ShlomoAbrams/ascon/docs/akiva/תאור פונקציית ההתמרה.pdf

בס"ד

## פונקציית התמורה - "permutations( "ובקיצור "P)"

קלט הפונקציה הינו ה - "State( "בקוד נקרא "INPUT_ STATE)". גודלו 320 סיביות, והוא מורכב מחמישה מילים שגודל כל אחד מהם 64 בית:

State = S0 ∥ S1 ∥ S2 ∥ S3 ∥ S4

0S - וקטור אתחול ה IV.

1S - חצי ראשון של המפתח - K.

2S - חצי שני של המפתח - K.

3S - חצי ראשון של ה-Nonce.

4S - חצי שני של ה-Nonce.

הפונקציה מבצעת מספר סיבובים - "Rounds( "ובקיצור "rnd )"הנע בטוח: 16 ≥ nr ≥ 1

כל סיבוב בפונקציה מורכב משלושה משלושה שלבים עיקריים, המתבצעים בזה אחר זה:

p = pL ∘ pS ∘ pC

.Constant Addition Layer - | הקבועים | הוספת | שכבת | – pC .1
.Substitution Layer - | ההחלפה | שכבת | – pS .2
.Linear Diffusion Layer - | הליניארית | הדיפוזיה | שכבת | – pL .3

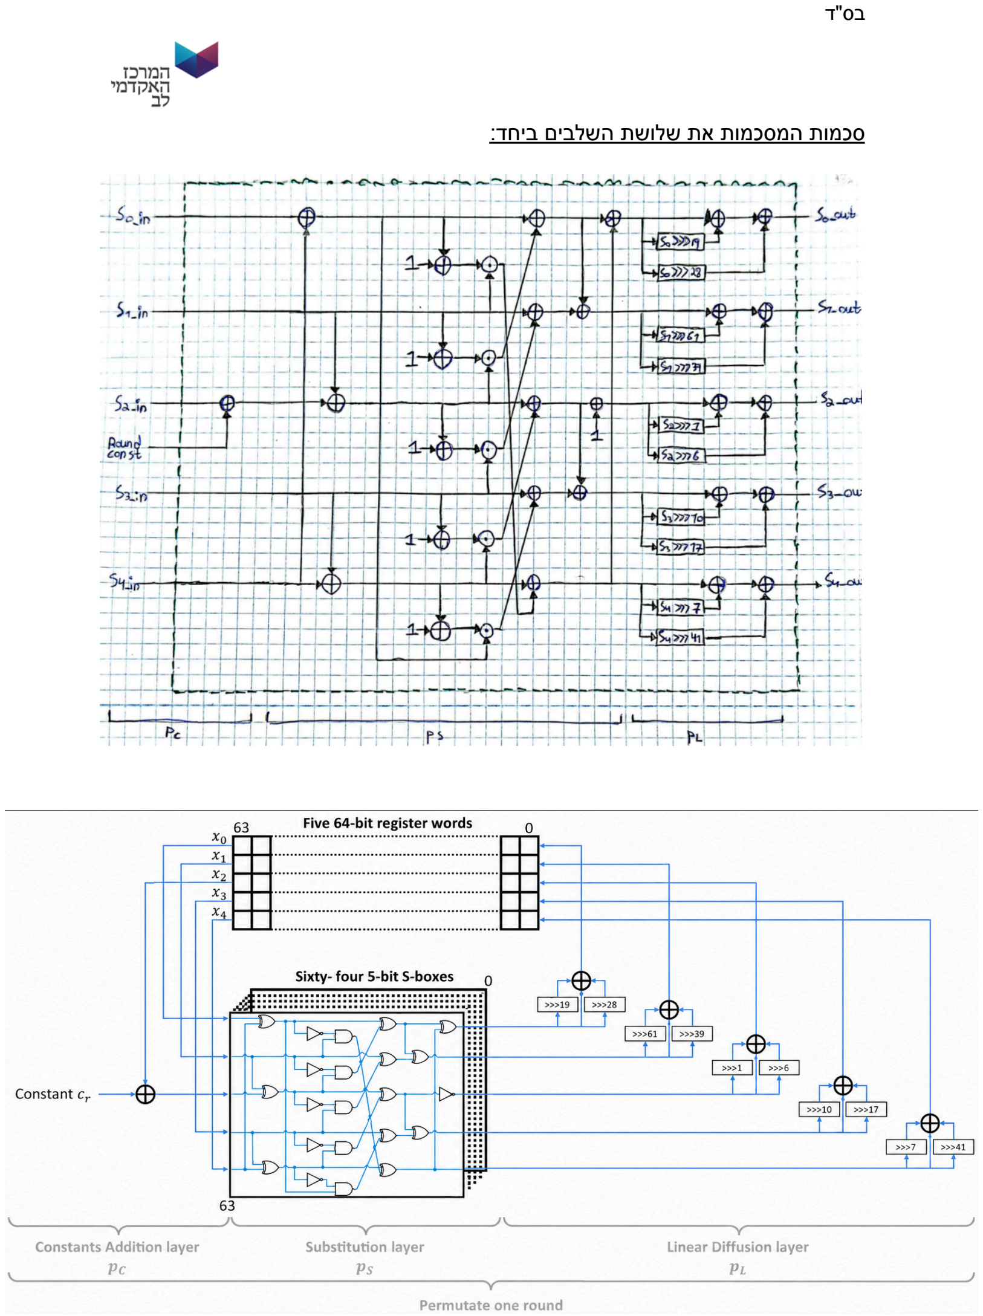
[picture p18: page 2]

סכמות המסכמות את שלושת השלבים ביחד:

שלושת השלבים בהרחבה:

.1 שלב ראשון - הוספת הקבועים:

ביצוע XOR בין בין המילה 2S שב - tatS לבין מספר קבוע, אחד מאלה המופיעים בטבלה הבאה:

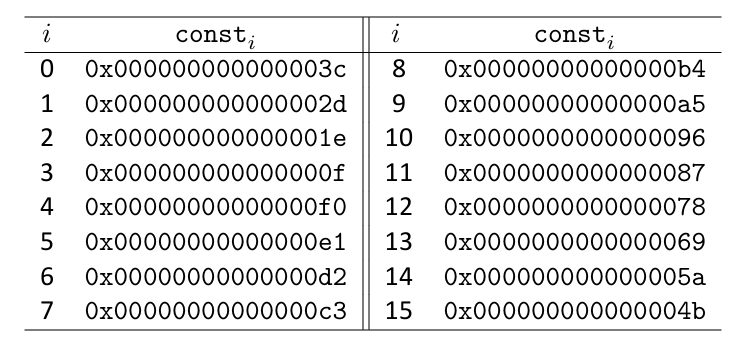
[picture p19: figure]

המספר הספציפי נקבע ע"פ הנוסחה הבאה:

Ci = const
16−rnd+i
אורך כל קבוע הינו 64 ביט, אך כיוון ש- 56 הביטים הראשונים שלו הם אפס, בפועל פעולת ה־XOR משפיעה רק על 8 הביטים ה LSB ׁ ׁ(הימניים ביותר( של 2S, ו- 56 הביטים הנותרים נשארים ללא שינוי.

מטרתו של כל שלב זה הינה יצירת הבדלים בין כל סיבוב ליתר הסיבובים.

סיגנל המוצא לאחר פעולה זו נקרא בקיצור pc( כלומר constan permutation -המצב אחרי הוספת הקבוע(.

.2 שלב שני - שכבת ההחלפה:

בהתייחס ל- State כמסודר בצורה "אנכית" באופן הבא:

נוצרות למעשה 64 קבוצות, כל קבוצה בעלת 5 ביטים בעלי אותו אינדקס המורכבת מחמשת המילים של ה State( ביט אחד מכל מילה(. בו זמנית עבור כל אחת מ- 64 הקבוצות, באופן מקביל, נכנסים כל חמישית ביטים ל"קופסה שחורה" שנקראת Box-S בה מחלפים את הביטים שנכנסו Xi, ומייצרים במוצא חמישה ביטים אחרים Yi.

(y0,..., y4) = SBOX(x0,..., x4) השינוי נקבע ע"פ הסכמה הבאה:

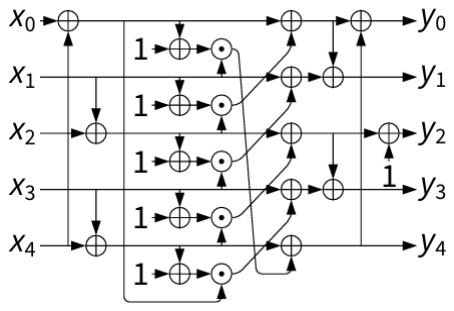
[picture p20: figure]

:הבא | באופן | מוגדרים | X0,X1,X2,X3,X4 | כאשר

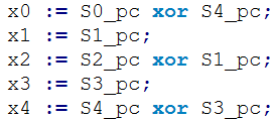
[picture p21: figure]

או בעזרת הטבלה הבאה בה מפורשים כל 32 הצירופים האפשריים:

מטרת שלב זה הינה ליצור "ערבוב" כך ששינוי של ביט אחד בקלט ישפיע על המון ביטים בפלט. פעולה זו יוצרת ערבוב לא-ליניארי חזק )מתמטיקה מורכבת(

לסיגנל המוצא לאחר פעולה זו נקרא בקיצור ps( כלומר permutation substitution - המצב אחרי ה- SBox).

.3 שלב שלישי - שכבת הפיזור )"דיפוזיה"( הליניארית: בשלב זה אנו מבצעים פיזור וערבוב בתוך כל אחת מ5- המילים ׂׂ)4S.…0S )בנפרד.

המטרה היא לגרום לכך ששינוי של ביט אחד יחיד יתפשט במהירות וישפיע על כל שאר הביטים בתוך המילה.
לכל אחת מ5- המילים יש נוסחת הזזה ייחודית משלה:

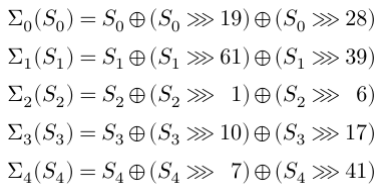
[picture p22: figure]

של עצמה, אנו מזיזים | 1 | בעזרת ביצוע XOR של כל מילה עם שתי גרסאות "מוזזות"
את הביטים ומפזרים אותם לכל אורך ה-State. למוצא לאחר פעולה זו נקרא: " OUTPUT_STATE" .

1
לכל מילה יש מרחקי הזזה שונים, שנקבעו כדי למקסם את הערבוב. )סימון הזזה: >>> (.

קידוד פונקצית התמורה:

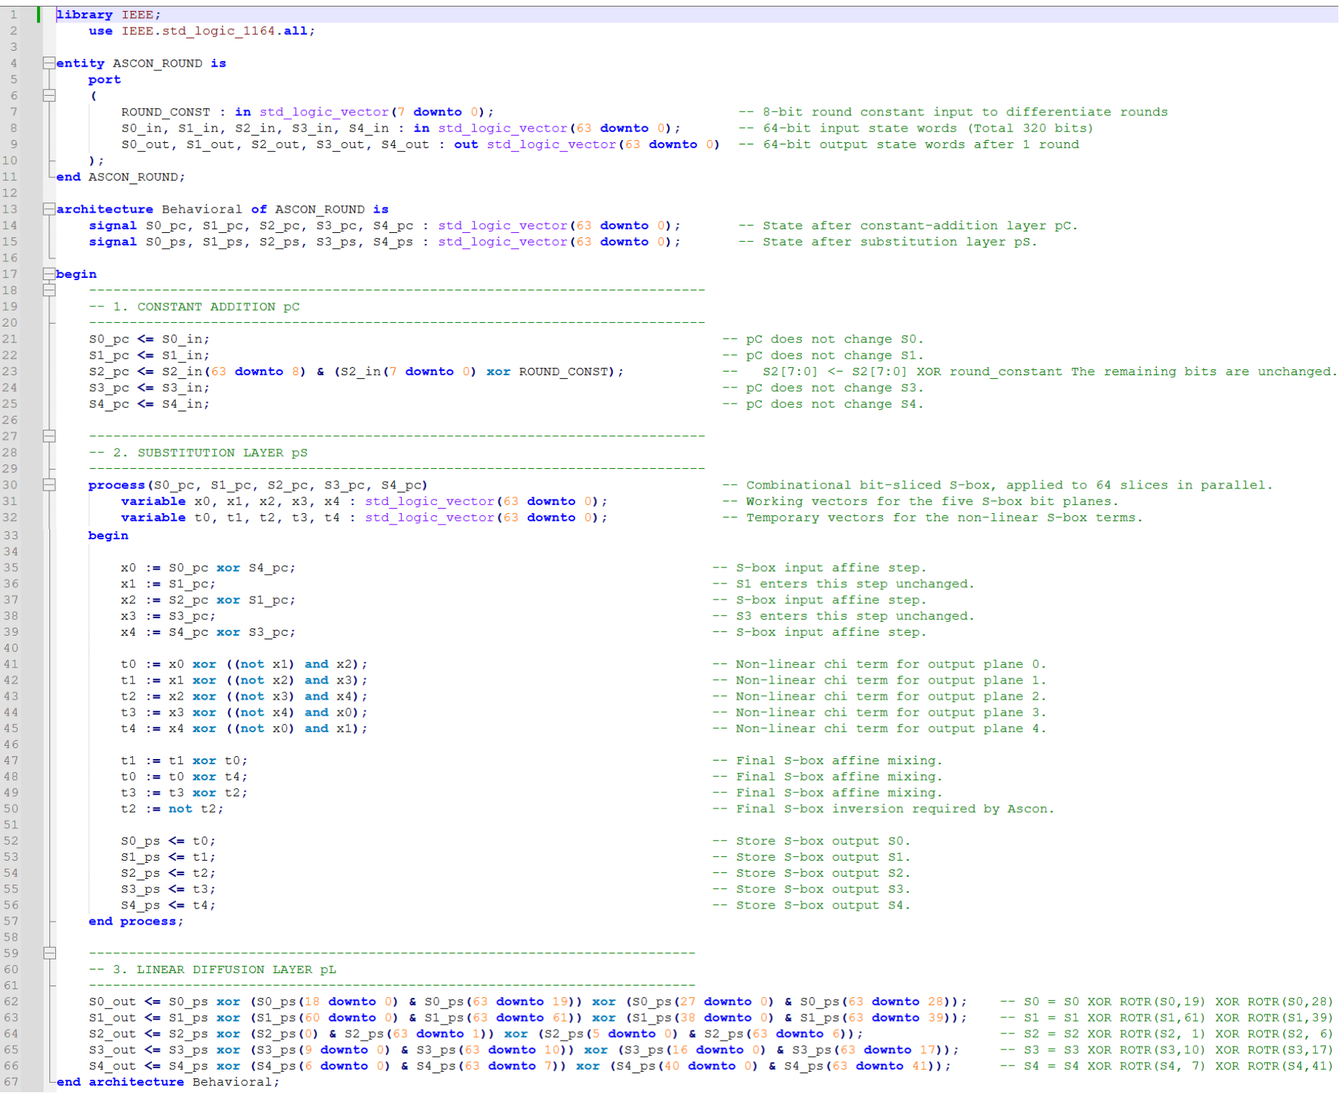
[picture p23: figure]
