ShlomoAbrams/ascon/docs/nist/NIST.SP.800-232.pdf

## NIST Special Publication 800 NIST SP 800-232

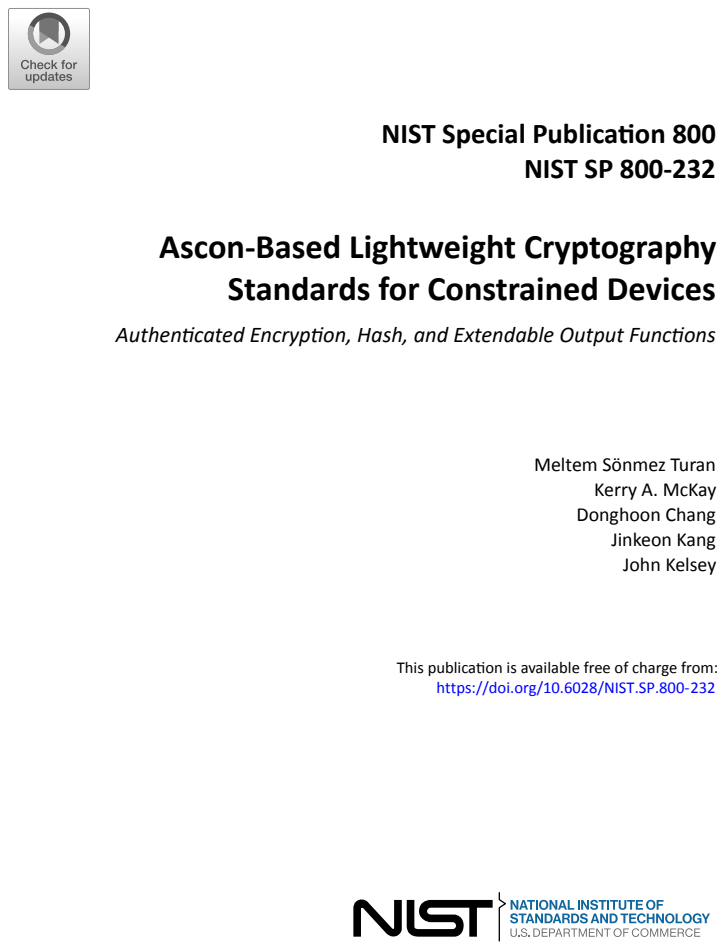
[picture p38: page 1]
Kerry A. McKay Donghoon Chang Jinkeon Kang John Kelsey

Ascon-Based Lightweight Cryptography
Standards for Constrained Devices

Authenticated Encryption, Hash, and Extendable Output Functions

Meltem Sönmez Turan

This publication is available free of charge from:
https://doi.org/10.6028/NIST.SP.800-232

## NIST Special Publication 800 NIST SP 800-232

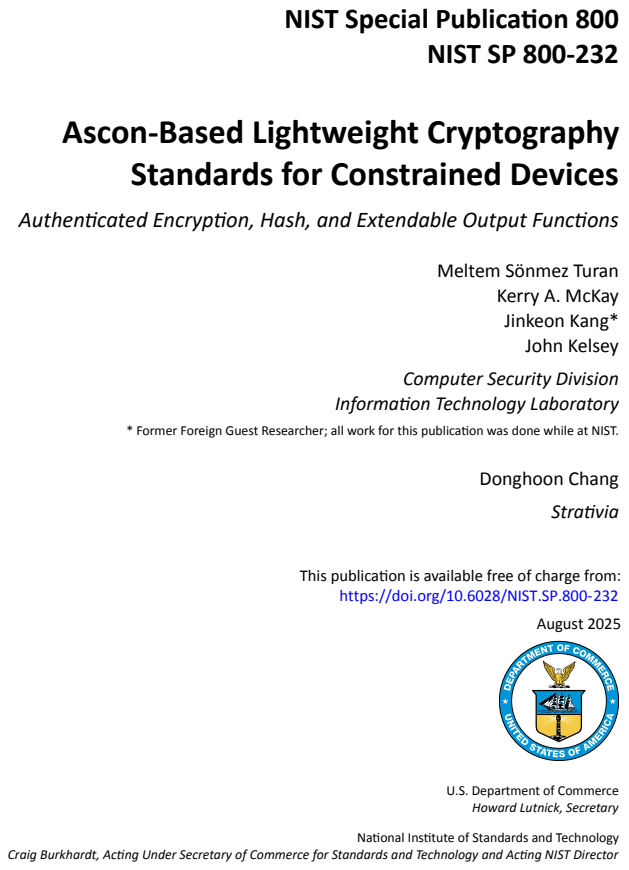
[picture p39: page 2]
Kerry A. McKay Jinkeon Kang* John Kelsey; Donghoon Chang; Strativia; August 2025

Ascon-Based Lightweight Cryptography
Standards for Constrained Devices

Authenticated Encryption, Hash, and Extendable Output Functions

Meltem Sönmez Turan

Computer Security Division

Information Technology Laboratory

* Former Foreign Guest Researcher; all work for this publication was done while at NIST.

This publication is available free of charge from:
https://doi.org/10.6028/NIST.SP.800-232

U.S. Department of Commerce
Howard Lutnick, Secretary

National Institute of Standards and Technology

Craig Burkhardt, Acting Under Secretary of Commerce for Standards and Technology and Acting NIST Director

NIST SP 800-232

### August 2025

Ascon-Based Lightweight Cryptography Standards for Constrained Devices

Certain equipment, instruments, software, or materials, commercial or non-commercial, are identified in this paper in order to specify the experimental procedure adequately. Such identification does not imply recommendation or endorsement of any product or service by NIST, nor does it imply that the materials or equipment identified are necessarily the best available for the purpose.

There may be references in this publication to other publications currently under development by NIST in accordance with its assigned statutory responsibilities. The information in this publication, including concepts and methodologies, may be used by federal agencies even before the completion of such companion publications. Thus, until each publication is completed, current requirements, guidelines, and procedures, where they exist, remain operative. For planning and transition purposes, federal agencies may wish to closely follow the development of these new publications by NIST.

Organizations are encouraged to review all draft publications during public comment periods and provide feedback to NIST. Many NIST cybersecurity publications, other than the ones noted above, are available at https://csrc.nist.gov/publications

Authority

This publication has been developed by NIST in accordance with its statutory responsibilities under the Federal Information Security Modernization Act (FISMA) of 2014, 44 U.S.C. § 3551 et seq., Public Law (P.L.) 113-283. NIST is responsible for developing information security standards and guidelines, including minimum requirements for federal information systems, but such standards and guidelines shall not apply to national security systems without the express approval of appropriate federal officials exercising policy authority over such systems. This guideline is consistent with the requirements of the Office of Management and Budget (OMB) Circular A-130.

Nothing in this publication should be taken to contradict the standards and guidelines made mandatory and binding on federal agencies by the Secretary of Commerce under statutory authority. Nor should these guidelines be interpreted as altering or superseding the existing authorities of the Secretary of Commerce, Director of the ORCID, or any other federal official. This publication may be used by nongovernmental organizations on a voluntary basis and is not subject to copyright in the United States. Attribution would, however, be appreciated by NIST.

NIST Technical Series Policies
Copyright, Use, and Licensing Statements (https://doi.org/10.6028/NIST-TECHPUBS.CROSSMARK-POLICY)
NIST Technical Series Publication Identifier Syntax (https://www.nist.gov/nist-research-library/nist-technical-series-publications-author-instructions)

Publication History
Approved by the NIST Editorial Review Board on 2025-07-09

How to cite this NIST Technical Series Publication:
Meltem Sönmez Turan, Kerry A. McKay, Donghoon Chang, Jinkeon Kang, John Kelsey (2025) Ascon-Based Lightweight Cryptography Standards for Constrained Devices. (National Institute of Standards and Technology, Gaithersburg, MD), NIST Special Publication (SP) NIST SP 800-232. https://doi.org/10.6028/NIST.SP.800-232

Standards for Constrained Devices

### August 2025

Author ORCID iDs
Meltem Sönmez Turan: 0000-0002-1950-7130 Kerry A. McKay: 0000-0002-5956-587X Donghoon Chang: 0000-0003-1249-2869 Jinkeon Kang: 0000-0003-2142-8236
John Kelsey: 0000-0002-3427-1744

Contact Information
SP800-232-comments@list.nist.gov

Additional Information
Additional information about this publication is available at https://csrc.nist.gov/pubs/sp/800/232/final, including related content, potential updates, and document history.

All comments are subject to release under the Freedom of Information Act (FOIA).

### August 2025

Standards for Constrained Devices

Abstract

In 2023, the National Institute of Standards and Technology (NIST) announced the selection of the Ascon family of algorithms designed by Dobraunig, Eichlseder, Mendel, and Schläffer to provide efficient cryptographic solutions for resource-constrained devices. This decision emerged from a rigorous, multi-round lightweight cryptography standardization process. The Ascon family includes a suite of cryptographic primitives that provide Authenticated Encryption with Associated Data (AEAD), hash function, and eXtendable Output Function (XOF) capabilities. The Ascon family is characterized by lightweight, permutation-based primitives and providesrobustsecurity, efficiency, and flexibility, making it ideal for resource-constrained environments, such as Internet of Things (IoT) devices, embedded systems, and low-power sensors. The family is developed to offer a viable alternative when the Advanced Encryption Standard (AES) may not perform optimally. This standard outlines the technical specifications and security properties of Ascon-AEAD128, Ascon-Hash256,
Ascon-XOF128, and Ascon-CXOF128.

Keywords

Ascon; authenticated encryption; constrained devices; eXtendable Output Function (XOF); hash function; lightweight cryptography; permutation-based cryptography; standardization.

Reports on Computer Systems Technology

The Information Technology Laboratory (ITL) at the National Institute of Standards and Technology (NIST) promotesthe U.S. economy and public welfare by providing technical leadership for the Nation’s measurement and standards infrastructure. ITL develops tests, test methods, reference data, proof of concept implementations, and technical analyses to advance the development and productive use of information technology. ITL’s responsibilities include the development of management, administrative, technical, and physical standards and guidelines for the cost-effective security and privacy of other than national securityrelated information in federal information systems. The Special Publication 800-series reports on ITL’s research, guidelines, and outreach efforts in information system security, and its collaborative activities with industry, government, and academic organizations.

i

### August 2025

Standards for Constrained Devices

### Patent Disclosure Notice

NOTICE: ITL has requested that holders of patent claims whose use may be required for compliance with the guidance or requirements of this publication disclose such patent claimsto ITL. However, holders of patents are not obligated to respond to ITL callsfor patents and ITL has not undertaken a patent search in order to identify which, if any, patents may apply to this publication.

As of the date of publication and following call(s) for the identification of patent claims whose use may be required for compliance with the guidance or requirements of this publication, no such patent claims have been identified to ITL.

No representation is made or implied by ITL that licenses are not required to avoid patent infringement in the use of this publication.

ii

### August 2025

Standards for Constrained Devices

## Table of Contents

3.3. Substitution Layer pS

iii

### August 2025

Standards for Constrained Devices

iv

### August 2025

Standards for Constrained Devices

## List of Tables

Table 5. The constants consti
to derive round constants of the Ascon permutations. 9

Table 7. Security strength of Ascon-AEAD128 with λ-bit tag in the u-key setting,

Table 8. Integrity security strength of Ascon-AEAD128 with u keys in the nonce-

## Table 9. Security strengths of Ascon-Hash256, Ascon-XOF128, and Ascon-CXOF128

Table 10. Address for each byte of Ascon state word Si
in memory on little-endian

Table 11. Examples of padding an unsigned integer x to a 64-bit block, where x encodes a sequence of bytes that each have value 0xFF in little-endian byte order ... 38

Table 12. Precomputed initialization phase valuesfor Ascon-Hash256, Ascon-XOF128,

v

### August 2025

Standards for Constrained Devices

## List of Figures

Figure 2. Application of substitution layer pS

Figure 10. Representation of the Ascon state as 64-bit unsigned integers, byte se-

vi

### August 2025

Standards for Constrained Devices

### Acknowledgments

The authors of the standard express their gratitude to the Ascon designers — Christoph Dobraunig, Maria Eichlseder, Florian Mendel, and Martin Schläffer — for their valuable comments and suggestions during the standardization process.

The authors also acknowledge and appreciate contributions from their colleagues at NIST during the selection process, including Lawrence Bassham, Çağdaş Çalık, Deukjo Hong, and Noah Waller. The authors also thank Elaine Barker, Luís T. A. N. Brandão, Lily Chen, Andrew Regenscheid, Noah Ross, Sara Kerman, Yu Long Chen, and Yu Sasaki for their technical and administrative support.

vii

### August 2025

Standards for Constrained Devices

### 1. Introduction

This standard specifies the Ascon family of algorithms to provide Authenticated Encryption with Associated Data (AEAD), a hash function, and two eXtendable Output Functions (XOFs). The Ascon family is designed to be efficient in constrained environments. The algorithms included in this standard are as follows:
1. Ascon-AEAD128 is a nonce-based AEAD scheme, offering 128-bit security strength

in the single-key setting.
2. Ascon-Hash256 is a cryptographic hash function that produces a 256-bit hash of the input messages, offering a security strength of 128 bits.
3. Ascon-XOF128 is a XOF, where the output size of the hash of the message can be

selected by the user, and the supported security strength is up to 128 bits.
4. Ascon-CXOF128 is a customized XOF that allows users to specify a customization string and choose the output size of the message hash. It supports a security strength of up to 128 bits.

Development of the Ascon family. Ascon (version v1) [1] was firstsubmitted to CAESAR (Competition for Authenticated Encryption: Security, Applicability, and Robustness)

1

1CAESAR is a competition organized by a group of international cryptologic researchers to identify a portfolio of authenticated encryption schemes that offer advantages over AES-GCM and are suitable for widespread adoption. The final portfolio of the competition was announced in February 2019. For more information, see https://competitions.cr.yp.to/caesar.html.

in 2014. The
submission included two AEAD algorithms: a primary recommendation, Ascon-128, with a 128-bit key and the secondary recommendation, Ascon-96, with a 96-bit key. Updated versions v1.1 [2] for Round 2 and v1.2 [3] for Round 3 included minortweaks,such asreordering the round constants, and the secondary recommendation was updated to Ascon-128a. In 2019, Ascon-128 and Ascon-128a were selected as the first choice for the lightweight authenticated encryption use case in the final portfolio of the CAESAR competition.

NIST Lightweight Cryptography Standardization Process. In 2015, the National Institute of Standards and Technology (NIST) initiated the Lightweight Cryptography Standardization Process to develop cryptographic standards that are suitable for constrained environments in which conventional cryptographic standards(e.g., AES-GCM [4, 5], SHA-2 [6] and SHA-3 [7] hash function families) may be resource-intensive. In February 2023, NIST announced the decision to standardize the Ascon family [8] for lightweight cryptography applications. For more information, refer to NIST Internal Report (IR) 8268 [9], IR 8369 [10], and IR 8454 [11].

Differencesfrom the Ascon submission v1.2. The technical differences between thisstandard and the Ascon submission [8] are provided below:

1. Permutations. The Ascon submission defined three Ascon permutations with 6, 8, and 12 rounds. This standard specifies additional Ascon permutations by providing round

### August 2025

Standards for Constrained Devices

constants for up to 16 rounds to accommodate potential functionality extensions in the future.

2. AEAD variants. The Ascon submission package defined AEAD variants ASCON-128, ASCON-128a, and ASCON-80pq. Thisstandard specifiesthe Ascon-AEAD128 algorithm,

which is based on ASCON-128a.

3. Hash function variants. The Ascon submission defined ASCON-HASH and ASCON-HASHA. This standard specifies Ascon-Hash256, which is based on ASCON-HASH.
4. XOF variants. The Ascon submission defined two XOFs, ASCON-XOF and ASCON-XOFA. This standard specifies Ascon-XOF128, which is based on ASCON-XOF, and a new customized XOF, Ascon-CXOF128.
5. Initial values. The initial values of the algorithms have been updated to support a new format that accommodates potential functionality extensions.
6. Endianness. The endianness has been switched from big endian to little endian to improve performance on little-endian microcontrollers.
7. Truncation and nonce masking. The implementation options of Ascon-AEAD128

with truncation and nonce masking have been added.

Main features of Ascon. The main features of the Ascon family are:

- Multiple functionalities. The same permutations are used to construct multiple functionalities, which allows an implementation of AEAD, hash, and XOF functionalities to share logic and, therefore, have a more compact implementation than functions that were developed independently.
- Online and single pass. Ascon-AEAD128 is online, meaning that the i-th ciphertext block is determined by the key, nonce, associated data, and first i plaintext blocks. Ascon family members require only a single pass over the data.
- Inverse-free. Since all of the Ascon family members only use the underlying permutations in the forward direction, implementing the inverse permutations is not needed.

Organization. Section 2 provides preliminaries, including the acronyms, terms, definitions, notation, basic operations, and auxiliary functions. Section 3 specifies the Ascon permutations for up to 16 rounds. Section 4 specifies the Ascon-AEAD128AEAD scheme, provides some implementation options for truncation and nonce masking, lists the requirements for validation, and provides security properties. Section 5 specifies the Ascon-Hash256 hash function, the Ascon-XOF128 XOF, and the Ascon-CXOF128 customized XOF and describes their security properties. Section 6 provides information about conformance. Appendix A provides additional notes and conversion functions for implementations. Appendix B provides additional information regarding the construction of initial values.

### August 2025

Standards for Constrained Devices

### 2. Preliminaries

Table 1 lists the acronyms used in this standard.

Table 1. Acronyms

Acronym | Definition
AD | Associated Data
AE | Authenticated Encryption
AEAD | Authenticated Encryption with Associated Data
AES | Advanced Encryption Standard
CAESAR | Competition for Authenticated Encryption: Security, Applicability, and Robustness
CXOF | Customized eXtendable-Output Function
GCM | Galois/Counter Mode
NIST | National Institute of Standards and Technology
SHA | Secure Hash Algorithm
SPN | Substitution–Permutation Network
SP | Special Publication
XOF | eXtendable-Output Function
XOR | eXclusive OR

Table 2 defines the terms used in this standard.

Table 2. Terms and definitions

Term | Definition
approved | An algorithm or technique that is either specified or adopted in a FIPS publication or NIST Special Publication (SP) in the Computer Security SP 800 series (i.e., FIPS-approved or NIST-recommended).
associated data | Input data that is authenticated but not encrypted.
bit | A binary digit, 0 or 1. In this standard, bits are indicated in the Courier New font.
bitstring | A finite, ordered sequence of bits.

### August 2025

Standards for Constrained Devices

Table 2. Terms and definitions

Term | Definition
capacity | The width of the underlying permutation minus the rate.
digest | Output of a hash function or XOF.
eXtendable- Output Function (XOF) | A function on bit strings in which the output can be extended to any desired length.

forgery

hash function

message | Input to the hash function.

nonce

nonce-misuse

nonce-respecting

rate

secret key

shall | Term used to express a requirement that needs to be fulfilled to claim conformance to this standard.
should | Term used to indicate a strong recommendation but not a requirement of this standard. Ignoring the recommendation could result in undesirable results.
tag | A cryptographic checksum on data that is designed to reveal both acciden- tal errors and the intentional modification of the data whose computation and verification require knowledge of a secret key.
truncation | A process that shortens an input bitstring, preserving only a sub-string of a specified length.

A cryptographic key that is used by a secret-key (i.e., symmetric) cryptographic algorithm and not made public.

The number of input bits processed or output bits generated per invocation of the underlying permutation.

A setting in which a nonce is never repeated for the encryption algorithm under a given key.

A setting in which a nonce is used more than once for the encryption algorithm under a given key.

An input value to the authenticated encryption algorithm that is used only once for encryption performed under a given key.

A mathematical function that maps a string of arbitrary length to a fixedlength string.

A (ciphertext, tag) pair produced by an adversary who is not knowledgeable of the secret key and yet is accepted as valid by the verified decryption procedure.

### August 2025

Standards for Constrained Devices

Table 3 lists the notations used in this standard.

Table 3. Notations

Notation | Definition
K | 128-bit secret key
N | 128-bit nonce
A | Associated data
Ai

i

th block of associated data A

P | Plaintext
Pi

i

th block of plaintext P

C | Ciphertext
Ci

i

th block of ciphertext C

Z | Customization string
Zi

i

th block of customization string Z

T | 128-bit authentication tag
IV | 64-bit constant initial value
fail | Error message to indicate that the verification of authenticated cipher-
text failed
M | Message
Mi

i

th block of message M

H | Hash value H
Hi

i

th block of hash value H

S | 320-bit internal state of the underlying permutation
S0

,…,S4

The five 64-bit words of the internal state S, where S = S0

‖ S1

‖ … ‖ S4

s(i,j) | j

th bit of S ,
i 0 ≤ i ≤ 4, 0 ≤ j ≤ 63
Si
[j] | j

tℎ byte of state word Si
for 0 ≤ i ≤ 4, 0 ≤ j ≤ 7
S[i∶j] | The subset of state S beginning at index and ending at index , inclusive.
When i > j, S[i∶j] is the empty string. When i = j, S[i∶j] is a single bit.
i | j
λ | Length of the truncated tag in bits
ci

The constant value for round i of the Ascon permutation
pC, pS

, pL Constant-addition, substitution, and linear layers of the round function p

### August 2025

Standards for Constrained Devices

Table 4 lists the basic operations and functions used in this standard.

Table 4. Basic operations and functions

Functions | Definition
{0,1}
∗ | The set of all finite bit strings, including the empty string
{0,1}
s | The set of all bit strings of length s
0
s | When | s

s ≥ 0, 0 is the bit string that consists of s consecutive 0s. When s = 0, then 0
s
is the empty string.
|X| | Length of the bitstring X in bits
X ‖Y | Concatenation of bitstrings X and Y
x × y | Multiplication of integers x and y
x +y | Addition of integers x and y
x − y | Subtraction of integers x and y
x/y | Division of integer x and non-zero integer y
x mod y | Remainder in the integer division of x by y
⌈x⌉ | For a real number x, the smallest integer greater than or equal
to x
⌊x⌋ | For a real number x, the largest integer less than or equal to x
f ∘ g | Composition of functions f and g (e.g., for functions f(x) and
g(x), f ∘ g is evaluated as f(g(x)))
⊙ | Bitwise AND operation
⊕ | Bitwise XOR operation
X ⋙ i | Rightrotation (circularshift) by i bits ofthe 64-bit word X, where
the least significant bit is the rightmost bit
X ≪ i | Left shift by i bits
X[i∶j] | The subset of bitstring X beginning at index i and ending at
index j, inclusive. When i > j, X[i∶j] is the empty string. When i = j, X[i∶j] is a single bit.
x == y | Boolean operator to perform an equality comparison, (i.e., true
if x is equal to y; otherwise, false)
0x | Hexadecimal notation
int64(x) | 64-bit representation of integer x

### August 2025

Standards for Constrained Devices

### 2.1. Auxiliary Functions

Parse function. The parse(X,r) function parses the input bitstring X into a sequence of blocks X0

,X1

,…,X̃ℓ
, where ℓ ← ⌊|X|/r⌋ (i.e., X ← X0

‖X1

‖… ‖X̃ℓ
). The Xi blocks for
0 ≤ i ≤ ℓ − 1 each have a bit length r, whereas 0 ≤ X̃ℓ ≤ r − 1 (see Algorithm 1). When |X| mod r = 0, the final block is empty (i.e., |X̃ℓ
| = 0).

Algorithm 1 parse(X,r)
Input: bitstring X, a positive integer r Output: bitstrings X0

,…,Xℓ−1,X̃ℓ

ℓ ← ⌊|X|/r⌋
for i = 0 to ℓ − 1 do
Xi ← X[i×r∶(i+1)×r−1]
end for

X̃ℓ ← X[ℓ×r∶|X|−1]

return X0

,…,Xℓ−1,X̃ℓ

Padding rule. The function pad(X,r) appends the bit 1 to the bitstring X, followed by the bitstring 0
j
, where j is equal to (−|X| − 1) mod r. The length of the output bitstring is a multiple of r (see Algorithm 2). For examples of padding when representing the data as 64-bit unsigned integers, see Appendix A.2.

Algorithm 2 pad(X,r)
Input: bitstring X, a positive integer r Output: padded bitstring X′

j ← (−|X| − 1) mod r
X′ ← X ∥ 1 ∥ 0
j
return X′

### August 2025

Standards for Constrained Devices

### 3. Ascon Permutations

This section specifies the rnd-round Ascon-p[rnd] permutations, where rnd indicates the number of rounds to be performed and 1 ≤ rnd ≤ 16. The permutations follow the Substitution-Permutation-Network (SPN) structure and consist of iterations of the round function p that is defined as the composition of three steps

p = pL ∘ pS

∘ pC, | (1)

where pC is the constant-addition layer (see Sec. 3.2), pS
is the substitution layer (see Sec. 3.3), and pL is the linear diffusion layer (see Sec. 3.4). This composition can also be written as a series of function invocations on an input x as pL(pS

(pC(x))).

Note that Ascon-p[8] and Ascon-p[12] are the main building blocks of the Ascon family, and the permutation instantiated with other numbers of rounds may later be used to standardize other functionalities.

### 3.1. Internal State

The permutations operate on the 320-bit state S, which is represented as five 64-bit words denoted as Si

for 0 ≤ i ≤ 4:

S = S0

∥ S1

∥ S2

∥ S3

∥ S4
. | (2)

Let s(i,j) represent the jth bit of Si

, 0 ≤ j < 64. In this specification of the Ascon permutation, each state word represents a 64-bit unsigned integer, where the least significant bit is the rightmost bit. Details on other representations of the state can be found in Appendix A.

### 3.2. Constant-Addition Layer pC

The constant ci of round i of the Ascon permutation Ascon-p[rnd] (instantiated with rnd rounds) for rnd ≤ 16 and 0 ≤ i ≤ rnd − 1 is defined as

ci = const16−rnd+i, | (3)

where const0

,…,const15 are defined in Table 5. The constant-addition layer pC adds a 64-bit round constant ci

to S2

in round i, for i ≥ 0,

S2 = S2 ⊕ ci

. | (4)

### August 2025

Standards for Constrained Devices

Table 5. The constants const to derive r i | ound constants of the Ascon permutations
i | const i | i | consti
0 | 0x000000000000003c | 8 | 0x00000000000000b4
1 | 0x000000000000002d | 9 | 0x00000000000000a5
2 | 0x000000000000001e | 10 | 0x0000000000000096
3 | 0x000000000000000f | 11 | 0x0000000000000087
4 | 0x00000000000000f0 | 12 | 0x0000000000000078
5 | 0x00000000000000e1 | 13 | 0x0000000000000069
6 | 0x00000000000000d2 | 14 | 0x000000000000005a
7 | 0x00000000000000c3 | 15 | 0x000000000000004b

Since the first 56 bits of the constants are zero, in practice, this is equivalent to applying the constant to only the least significant eight bits of S2
, as shown in Figure 1.

S0
S1
S2
S3
S4

Figure 1. Application of constant-addition layer pC to Ascon state

### 3.3. Substitution Layer pS

The substitution layer pS updates the state S with 64 parallel applications of the 5-bit substitution box SBOX as

(s(0,j),s(1,j),…,s(4,j)) = SBOX(s(0,j),s(1,j),…,s(4,j)) | (5)

for 0 ≤ j < 64, as shown in Figure 2.

S0
S1
S2
S3
S4

Figure 2. Application of substitution layer pS to Ascon state

The 5-bit SBOX is computed as (y0

,...,y4

) = SBOX(x0

,...,x4

), | (6)

where
y0 = x4x1 ⊕ x3 ⊕ x2x1 ⊕ x2 ⊕ x1x0 ⊕ x1 ⊕ x0

,
y1 = x4 ⊕ x3x2 ⊕ x3x1 ⊕ x3 ⊕ x2x1 ⊕ x2 ⊕ x1 ⊕ x0

,
y2 = x4x3 ⊕ x4 ⊕ x2 ⊕ x1 ⊕ 1,
y3 = x4x0 ⊕ x4 ⊕ x3x0 ⊕ x3 ⊕ x2 ⊕ x1 ⊕ x0

,
y4 = x4x1 ⊕ x4 ⊕ x3 ⊕ x1x0 ⊕ x1

| (7)

### August 2025

Standards for Constrained Devices

SBOX may also be implemented as a lookup table, as shown in Table 6. The circuit representation of the SBOX is given in Figure 3.

Table 6. Lookup table representation of SBOX
x | 0 | 1 | 2 | 3 | 4 | 5 | 6 | 7 | 8 | 9 | a | b | c | d | e | f
SBOX(x) | 4 | b | 1f | 14 | 1a | 15 | 9 | 2 | 1b | 5 | 8 | 12 | 1d | 3 | 6 | 1c
x | 10 | 11 | 12 | 13 | 14 | 15 | 16 | 17 | 18 | 19 | 1a | 1b | 1c | 1d | 1e | 1f
SBOX(x) | 1e | 13 | 7 | e | 0 | d | 11 | 18 | 10 | c | 1 | 19 | 16 | a | f | 17
Note that 5-bit inputs are represented in hexadecimal (e.g., x =1 corresponds to (0, 0, 0, 0, 1)).

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
Figure 3. Circuit representation of the 5-bit S-box SBOX

### 3.4. Linear Diffusion Layer pL

The linear diffusion layer pL provides diffusion within each 64-bit word Si , as shown in
Figure 4.

S0
S1
S2
S3
S4

Figure 4. Application of linear diffusion layer pL to Ascon state

This layer applies the linear functions Σi

to their corresponding state words as Si ← Σi

(Si

)
for 0 ≤ i ≤ 4, where each Σi is defined as:
Σ0

(S0

) = S0 ⊕ (S0 ⋙ 19) ⊕ (S0 ⋙ 28) | (8)
Σ1

(S1

) = S1 ⊕ (S1 ⋙ 61) ⊕ (S1 ⋙ 39) | (9)
Σ2

(S2

) = S2 ⊕ (S2 ⋙ 1) ⊕ (S2 ⋙ 6) | (10)
Σ3

(S3

) = S3 ⊕ (S3 ⋙ 10) ⊕ (S3 ⋙ 17) | (11)
Σ4

(S4

) = S4 ⊕ (S4 ⋙ 7) ⊕ (S4 ⋙ 41) | (12)

### August 2025

Standards for Constrained Devices

### 4. Authenticated Encryption Scheme: Ascon-AEAD128

This section specifies the AEAD scheme Ascon-AEAD128, details implementation options (e.g., truncation and nonce-masking), lists AEAD requirements, and provides security properties.

### 4.1. Specification of Ascon-AEAD128

Ascon-AEAD128 consists of the encryption algorithm Ascon-AEAD128.enc (specified in Sec. 4.1.1) and the decryption algorithm Ascon-AEAD128.dec (specified in Sec. 4.1.2).

Ascon-AEAD128.enc takes a 128-bit secret key K, a 128-bit nonce N, variable-length associated data A, and variable-length plaintext P as inputs and outputs ciphertext C (where |C| = |P |) and 128-authentication tag T (see Sec. 4.2.1 for the truncation option):
Ascon-AEAD128.enc(K,N,A,P ) = (C,T ) | (13)

Ascon-AEAD128.dec takes key K, nonce N, associated data A, ciphertext C, and authentication tag T as inputs and outputs P if the tag is valid:

Ascon-AEAD128.dec(K,N,A,C,T ) = {P if the tag Tis valid fail otherwise

(14)

### 4.1.1. Encryption

This section outlines the encryption algorithm of Ascon-AEAD128, which comprises four phases: initialization, associated data processing, plaintext processing, and finalization (see Figure 5).
Note that the rate and capacity of Ascon-AEAD128 are 128 and 192 bits, respectively.

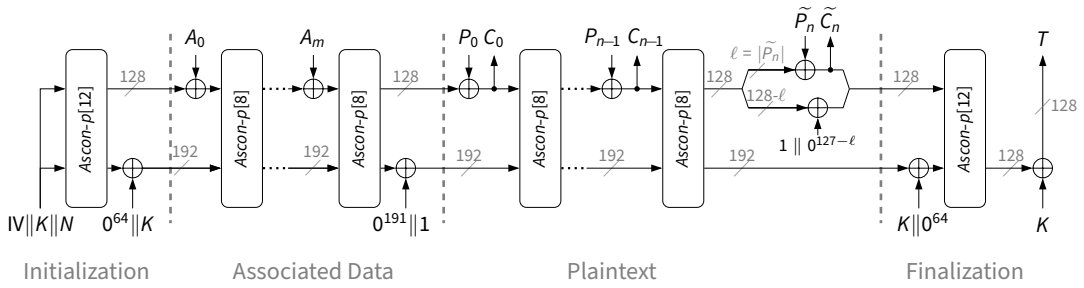
[picture p40: figure]
Ascon-p[12]; Initialization; Ascon-p[8]; Associated Data; Plaintext; Pen Cen; ℓ = |Pen|; Finalization

## Figure 5. Ascon-AEAD128 encryption

The pseudocode of Ascon-AEAD128.enc is provided in Algorithm 3.

### August 2025

Standards for Constrained Devices

## Algorithm 3 Ascon-AEAD128.enc(K,N,A,P )

Input: 128-bit key K, 128-bit nonce N, associated data A, plaintext P
Output: ciphertext C, 128-bit tag T
IV ← 0x00001000808c0001 | ▷ Initialization
S ← IV ‖K ‖N
S ← Ascon-p[12](S)
S ← S ⊕ (0
192 ‖K)
if |A| > 0 then | ▷ Processing associated data
A0

,…,Am−1,Ãm ← parse(A, 128)
Am ←pad(Ãm, 128)
for i = 0 to m do
S ← Ascon-p[8]((S[0∶127] ⊕ Ai

) ‖S[128∶319])
end for
end if
S ← S ⊕ (0

319 ‖1)

P0

,…,Pn−1,P̃n ← parse(P , 128) | ▷ Processing plaintext
ℓ ← |P̃n|
for i = 0 to n − 1 do
S[0∶127] ← S[0∶127] ⊕ Pi
Ci ← S[0∶127]
S ← Ascon-p[8](S)
end for
S[0∶127] ← S[0∶127]⊕pad(P̃n, 128)

C̃n ← S[0∶ℓ−1]

C ← C0

‖… ‖Cn−1 ‖C̃n

S ← Ascon-p[12](S ⊕ (0

128 ‖K ‖0
64)) | ▷ Finalization

T ← S[192∶319] ⊕K

return C,T

### August 2025

Standards for Constrained Devices

1. Initialization of the state. Given a 128-bit K and a 128-bit N, the 320-bit internal state S is initialized as the concatenation of IV, K, and N:
S ← IV ∥K ∥N, | (15)

where the initialization value IV is 0x00001000808c0001 (see Appendix B for details on determining the IV and Appendix A for implementation notes regarding initialization). Next, S is updated using the permutation Ascon-p[12] as

S ← Ascon-p[12](S) | (16)

and followed by XORing the secret key K into the last 128 bits of internal state:

S ← S ⊕ (0
192 ∥K). | (17)
2. Processing associated data. This step has two parts, including absorbing the associated data (when it is non-empty) and applying the domain separation bit to the state.
- If the AD is non-empty (i.e., |A| > 0): The associated data A is parsed into blocks as
A0

, A1

, …, Am−1, Ãm ← parse(A, 128), | (18)

where m = ⌊|A|/128⌋ and |Ai

| = 128 bits for 0 ≤ i ≤ m − 1 and 0 ≤ |Ãm| < 128, as explained in Algorithm 1. The last block Ãm can be empty. Next, Ãm is

padded as
Am ← pad(Ãm,128) = Ãm||1 ∥ 0
127−|Ãm| | (19)

so that |Am| = 128, as explained in Algorithm 2.

Each associated data block Ai

(0 ≤ i ≤ m) is absorbed into the first 128 bits of state as
S[0∶127] ← S[0∶127] ⊕ Ai
, | (20)

and the permutation Ascon-p[8] is applied to the state as

S ← Ascon-p[8](S). | (21)

The finalstep of processing associated data isto update the state with a constant

S ← S ⊕ (0

319 ∥1) | (22)

that provides domain separation.

### August 2025

Standards for Constrained Devices

- If the AD is empty (i.e., |A| = 0): Only the finalstep described in (22) is applied.
3. Processing plaintext. Plaintext P (including empty plaintext) is parsed into blocks as

P0

, P1

, …, Pn−1,P̃n ← parse(P , 128), | (23)

where n = ⌊|P |/128⌋, |Pi

| = 128 for 0 ≤ i ≤ n − 1, and |P̃n| = ℓ, 0 ≤ ℓ < 128 using
Algorithm 1. When |P | mod 128 = 0, the last block P̃n is empty.

For each Pi

, 0 ≤ i ≤ n − 1, the state S is updated as

S[0∶127] ← S[0∶127] ⊕ Pi

, | (24)

followed by generating the corresponding ciphertext block Ci as

Ci ← S[0∶127], | (25)

and the permutation Ascon-p[8] is applied to update the state as

S ← Ascon-p[8](S). | (26)

For the last block P̃n, the state is updated as

S[0∶127] ← S[0∶127] ⊕pad(P̃n, 128), | (27)

and the last ciphertext block C̃n is obtained as

C̃n ← S[0∶ℓ−1]. | (28)

The ciphertext C is constructed by concatenating the ciphertext blocks as

C ← C0

∥… ∥Cn−1 ∥C̃n. | (29)
4. Finalization and tag generation. During finalization, the key is first loaded to the state S as
S ← S ⊕ (0

128 ∥K ∥0
64), | (30)

and the state S is then updated using the permutation Ascon-p[12] as

S ← Ascon-p[12](S). | (31)

Finally, the tag T is generated by XORing the key with the last 128 bits of the state:

T ← S[192∶319] ⊕K. | (32)

The encryption algorithm returns the ciphertext C and the tag T.

### August 2025

Standards for Constrained Devices

### 4.1.2. Decryption

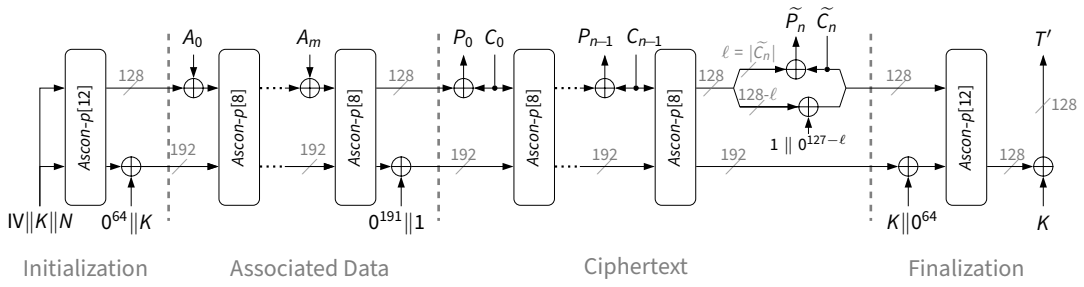
[picture p41: figure]
Ascon-p[12]; Initialization; Ascon-p[8]; Associated Data; Ciphertext; Pen Cen; ℓ = |Cen|; Finalization

## Figure 6. Ascon-AEAD128 decryption

Thissection describes each of the phasesfor decryption with Ascon-AEAD128.dec. Decryption in Ascon-AEAD128 consists of four phases: initialization, associated data processing, ciphertext processing, and finalization. Decryption in Ascon-AEAD128 is similar to encryption; only the last two phases differ from the encryption mode.
The pseudocode of Ascon-AEAD128.dec is provided in Algorithm 4.
1. Initialization of the state. Given a 128-bit K and 128-bit N, the 320-bit internal state S is initialized as the concatenation of IV, K, and N:
S ← IV ∥K ∥N, | (33)

where the initial value IV is 0x00001000808c0001 (see Appendix B for details on determining the IV and Appendix A for implementation notes regarding initialization). Next, S is updated using the permutation Ascon-p[12] as

S ← Ascon-p[12](S) | (34)

and followed by XORing the secret key into the last 128 bits of the state as

S ← S ⊕ (0
192 ∥K). | (35)

This step is exactly the same as Step 1 of the encryption function in Sec. 4.1.1.

2. Processing associated data. This step has two parts, including absorbing the associated data (when it is non-empty) and applying the domain separation bit to the state.
- If the AD is non-empty (i.e., |A| > 0): The associated data A is parsed into blocks as
A0

, A1

, …, Am−1, Ãm ← parse(A, 128), | (36)

### August 2025

Standards for Constrained Devices

## Algorithm 4 Ascon-AEAD128.dec(K,N,A,C,T )

Input: 128-bit key K, 128-bit nonce N, associated data A, ciphertext C, 128-bit tag T Output: plaintext P or fail
IV ← 0x00001000808c0001 | ▷ Initialization
S ← IV ‖K ‖N
S ← Ascon-p[12](S)
S ← S ⊕ (0
192 ‖K)
if |A| > 0 then | ▷ Processing associated data
A0

,…,Am−1,Ãm ← parse(A, 128)
Am ←pad(Ãm, 128)
for i = 0 to m do
S ← Ascon-p[8]((S[0∶127] ⊕ Ai

) ‖S[128∶319])
end for
end if
S ← S ⊕ (0

319 ‖1)

C0

,…,Cn−1,C̃n ← parse(C, 128) | ▷ Processing ciphertext
for i = 0 to n − 1 do
Pi ← S[0∶127] ⊕ Ci
S[0∶127] ← Ci
S ← Ascon-p[8](S)
end for
ℓ = |C̃n|

P̃n ← S[0∶ℓ−1] ⊕C̃n

S[ℓ∶127] ← S[ℓ∶127] ⊕ (1||0¹²⁷⁻ℓ)

S[0∶ℓ−1] ← C̃
n
S ← Ascon-p[12](S ⊕ (0

128 ‖K ‖0
64)) | ▷ Finalization
T

′ ← S[192∶319] ⊕K

if T

′ == T then
P ← P0

‖… ‖Pn−1 ‖P̃n
return P
else
return fail

end if

### August 2025

Standards for Constrained Devices

where m = ⌊|A|/128⌋ and |Ai

| = 128 bits for 0 ≤ i ≤ m − 1 and 0 ≤ |Ãm| < 128, as explained in Algorithm 1. The last block Ãm can be empty.

Ãm is further processed by padding to a full r = 128-bit block using Algorithm

2 as
Am ← pad(Ãm, 128) = Ãm||1 ∥ 0

127−|Ãm|
. | (37)

The associated data blocks Ai

’s (0 ≤ i ≤ m) are absorbed into the state S as follows:
S[0∶127] ← (S[0∶127] ⊕ Ai
), | (38)

and the permutation Ascon-p[8] is applied to the state as

S ← Ascon-p[8](S). | (39)

The final step of processing associated data is to update the state to

S ← S ⊕ (0

319 ∥1) | (40)

for domain separation.

- If the AD is empty (i.e., |A| = 0): Only the final step described in Equation (40) is applied.

This step is exactly the same as Step 2 of the encryption function in Sec. 4.1.1.

3. Processing the ciphertext. Ciphertext C is parsed into blocks as

C0

, C1

, …,Cn−1, C̃n ← parse(C, 128), | (41)

where n = ⌊|C|/128⌋, |Ci

| = 128 for 0 ≤ i ≤ n − 1, |C̃n| = ℓ and 0 ≤ ℓ < 128 using Algorithm 1. Ciphertext C or the last block of ciphertext C̃n can be empty.

For each Ci

, 0 ≤ i ≤ n − 1, the following steps are applied:

Pi ← S[0∶127] ⊕ Ci | (42)
S[0∶127] ← Ci | (43)
S ← Ascon-p[8](S). | (44)

For the last block of the ciphertext C̃n (with length ℓ), the following steps are applied:

P̃n ← S[0,ℓ−1] ⊕ C̃n | (45)
S[0,ℓ−1] ← C̃n | (46)
S[ℓ,127] ← S[ℓ,127] ⊕ (1||0¹²⁷⁻ℓ). | (47)

### August 2025

Standards for Constrained Devices

Note that when C̃n is an empty block, P̃n is an empty block as well.

The plaintext P is constructed by concatenating the plaintext blocks as

P ← P0

∥… ∥Pn−1 ∥P̃n. | (48)
4. Finalization. During finalization, the key is loaded into the state S as

S ← S ⊕ (0

128 ∥K ∥0
64), | (49)

and the state S is then updated using the permutation Ascon-p[12]as

S ← Ascon-p[12](S). | (50)

Finally, the tag is generated by XORing the key with the last 128 bits of the state:

T

′ ← (S[192∶319]) ⊕K. | (51)

As the last step, the computed T

′
is compared with the input T. If the two match, the plaintext P is returned. Otherwise, an error message fail is returned.

### 4.2. Implementation Options

### 4.2.1. Truncation

Some applications may truncate the tag T to a specific length λ (≤ |T |). The truncation function outputs the leftmost λ bits of the tag (i.e., T[0∶λ−1]).

The requirements on the tag lengths are provided in Sec. 4.3.

### 4.2.2. Nonce Masking

In this option, an additional 128-bit key is used to mask the input nonce. Let K = (K1

‖K2

)
be a 256-bit key, where |K1

| = |K2

| = 128. Ascon-AEAD128 with nonce masking is processed as follows:

E(K1
∥K2

## ,N,A,P ) = Ascon-AEAD128.enc(K1

,N ⊕K2

,A,P ), | (52)

D(K1
∥K2

## ,N,A,C,T ) = Ascon-AEAD128.dec(K1

,N ⊕K2

,A,C,T ) (53)

### August 2025

Standards for Constrained Devices

Ascon-AEAD128 with nonce masking should only be used when context-commitment security 2
[

2
In AEAD schemes, context commitment is a security property that ensures a ciphertext cannot be decrypted successfully under two different, adversarially-chosen contexts – where context includes a secret key, nonce, and associated data.

12] and related-key security [13] are not concerns. This is because the encryption of Ascon-AEAD128 with nonce masking always outputs the same (C, T ) pair for two different
input | ′ | ″ | ′ | ′ | ′ | ″ tuples (K ‖K ,N,A,P ) and (K ‖K ,N ,A,P ), where N ⊕K = N ⊕K .

When the output tag is not truncated, this option maintains its 128-bit security strength in both single-key and multi-key settings [14] (see Section 4.4.2).

### 4.3. AEAD Requirements

This section specifies requirements for Ascon-AEAD128.

R1. Key generation. The secret key and the nonce-masking key (if available) shall be

generated following the recommendations for cryptographic key generation specified in SP 800-133 [15] and using an approved random bit generator that supports at least a 128-bit security strength. The keys shall not be used for other purposes.
R2. Secrecy of key. The Ascon-AEAD128 key shall be kept secret. When the nonce masking option is implemented, the masked nonce (i.e., N ⊕ K2
in Equation (52))
shall also be kept secret.
R3. Use of unique nonce. Nonces shall be distinct for each encryption algorithm for a

given key to ensure that identical plaintexts encrypted multiple times produce different ciphertexts.
R4. Minimum length of truncated tag. When an application uses truncated tags, the

bit length of the truncated tags shall be at least 32 bits and shall only select a tag length less than 64 bits after a careful risk analysis is performed. The tag length shall be the same across the lifespan of the key.

## R5. Limit on the maximum number of decryption failures. When the tag bit length

λ satisfies 64 ≤ λ ≤ 128, the probability of a forgery is low enough that decryption failures up to 2

λ−32 can be tolerated without compromising security. Therefore, the maximum number of decryption failures under a fixed key shall not exceed 2

| | | | | | λ−32
. For
shorter tags, with 32 ≤ λ < 64, the forgery probability is higher, in these cases, the number of allowable decryption failures should be limited to 1. However, if a careful risk analysis shows that the system’s overall security goal remains satisfied, this limit may be relaxed – up to the same bound of 2

λ−32
R6. Data limit. The total amount of data processed during encryption and decryption, including the nonce, shall not exceed 2
| | | 54 bytes for a given key.

### August 2025

Standards for Constrained Devices

R7. Key update. The key shall be updated to a new key once the total amount of input data reaches the limit of 2

54 bytes, and should be updated when the number of decryption failures reaches its limit.

### 4.4. Security Properties

This section provides the security properties of Ascon-AEAD128 in various scenarios, in-

cluding single-key and multi-key settings, nonce-respecting and nonce-misuse settings, and with or without the truncation option.

In the single-key setting, the security of the scheme is analyzed under the assumption that the scheme uses a single key; in contrast, in the multi-key setting, multiple independent keys are used, and the adversary may interact with many instances of the scheme, each with a different key. The security of the Ascon-AEAD128 mode in both single-key and multi-key settings was evaluated in [14, 16–19]. The committing security of the Ascon-AEAD128 mode was also evaluated in [20, 21].

### 4.4.1. Single-Key Setting

Ascon-AEAD128 with no tag truncation provides a 128-bitsecurity strength in the single-key and nonce-respecting setting for the confidentiality of the plaintext (except for its length) and the integrity of the tuple (nonce, associated data, ciphertext, tag), where the total number of input bytes is limited to 2

54 (i.e., 2

50 blocks).

Impact of truncation. For a tag of length λ, a forgery attempt succeeds with a probability of 2

−λ
. Once a forgery is successful, the confidentiality of the plaintext may be compromised, as the decryption algorithm could reveal some information about the plaintext. Therefore, in the single-key setting, Ascon-AEAD128 with tag length λ provides λ-bit security for both confidentiality and integrity in the nonce-respecting setting.Note that even if a forgery attempt is successful, the probability of another successful forgery is 2

−λ
, provided that
the secret key remains uncompromised. This also holds for the nonce masking option.

### 4.4.2. Multi-Key Setting

When u keys are independently selected for an application, Ascon-AEAD128 with no tag truncation provides a (128 −log2

u)-bit security strength in the nonce-respecting setting for the confidentiality of the plaintext and the integrity of the tuple (nonce, associated data, ciphertext, tag). Note that, in the nonce-respecting setting, an attacker may select the same nonce for use with different keys, but is not permitted to reuse a nonce with the same key.

When the same nonce is used with u keys, an attacker may discover one of the u keys with a time complexity of 2

128−log2

u
, thereby compromising both confidentiality and integrity [14, 17–19].

### August 2025

Standards for Constrained Devices

To improve security in a multi-key setting, the nonce-masking implementation option with no truncation (see Sec. 4.2.2) can be used. This option provides 128-bit security (rather than 128−log2

u) for confidentiality and integrity.

Impact of truncation. In the multi-key setting, Ascon-AEAD128 with tag length λ provides min{128 −log2

u,λ}-bit security for both confidentiality and integrity in the nonce-respecting setting. Additionally, when using the nonce-masking option with tag length λ, it provides λ-bit security for both confidentiality and integrity in the same setting. Note that, similar to the single-key case, even if a forgery attempt is successful, the probability of another successful forgery is 2

−λ
, provided that the secret key is uncompromised.

### 4.4.3. Nonce-Misuse Setting

The confidentiality of plaintext both in Ascon-AEAD128 and Ascon-AEAD128 with nonce masking can be compromised if a nonce or, more specifically, (nonce, associated data) pair, is reused with the same secret key. However, these algorithms are designed to provide some resilience against unintentional nonce reuse.

When (N, A) pairs are distinct for encryption per key: In the u-key setting, where u = 1 corresponds to a single key and u > 1 to multiple independent keys, the confidentiality and integrity guarantees of Ascon-AEAD128 and the nonce-masking option with a λ-bit tag are as follows:
- Ascon-AEAD128 provides min{128 −log2
u,λ} bits of security for both confidentiality and integrity.
- Nonce-masking option provides λ-bit security for both confidentiality and integrity.

These guarantees assume that each (N, A) pair is used at most once per key, and that any given nonce is reused for encryption with the same key no more than 2

8 times. Additionally,
even after a successful forgery, the probability of anothersuccessful forgery attemptremains at most 2

−λ
, provided that none of the multiple keys is compromised. The resulting security levels under these conditions are summarized in Table 7.
Table 7. Security strength of Ascon-AEAD128 with λ-bit tag in the u-key setting, where (N, A) pairs are distinct for encryption per key
Security | Security strength in bits | Total number of repetitions of a nonce
Confidentiality of plaintext | u,λ} min{128 −log2 | ≤ 2⁸
Integrity of (N,A,C,T) | u,λ} min{128 −log2 | ≤ 2⁸

When each (N, A) pair are reused up to 2

8 times for encryption per key: In the u-key setting, where u denotes the number of independent keys, the integrity security guarantees of Ascon-AEAD128 and the nonce-masking option with a λ-bit tag are as follows:

### August 2025

Standards for Constrained Devices

- Ascon-AEAD128 provides min{128 −log2
u,λ} bits of integrity security.
- Nonce-masking option provides λ-bit integrity security.

These guarantees hold under the condition that each (N, A) pair is reused at most 2

8 times
for encryption with the same key. The corresponding integrity security levels are summarized in Table 8. Furthermore, for both Ascon-AEAD128 and the nonce-masking option, even after a successful forgery, the probability that a subsequent forgery attempt succeeds remains at most 2

−λ
, provided that none of the multiple keys has been compromised.

Table 8. Integrity security strength of Ascon-AEAD128 with u keys in the nonce-misuse

setting

Security | Security strength in bits | Total number of repetitions of any (N, A) pair
Integrity of (N,A,C,T) | min{128 −log2 u,λ} | ≤ 2⁸

### August 2025

Standards for Constrained Devices

### 5. Hash and eXtendable-Output Functions (XOFs)

Hash and XOF algorithms are built on the Ascon-p[12] permutation in a sponge-based mode. This section specifies three functions:
1. Hash function Ascon-Hash256, which produces a 256-bit digest
2. Ascon-XOF128 function that produces arbitrary length outputs
3. Customized XOF Ascon-CXOF128, which also produces arbitrary length outputs

The designs of these functions differ from the design of Ascon-AEAD128 in three important ways. First, they employ traditional sponge-based modes that only extract output from the state after all input data has been absorbed. Second, the rate of these functions is reduced to 64 bits — half the rate used in Ascon-AEAD128. Finally, the hash and XOF algorithms rely only on the Ascon-p[12] permutation, whereas Ascon-AEAD128 employs both Ascon-p[12] and Ascon-p[8].

In Ascon-XOF128, when different output lengths are specified for the same input message, the shorter output is a prefix of the longer one. If this prefix property is undesirable in a given application, domain separation offers a more robust solution. For instance, Ascon-CXOF128 enables domain separation by allowing output lengths to be encoded into the user-defined customization string.

### 5.1. Specification of Ascon-Hash256

The mode of operation used by Ascon-Hash256 and Ascon-XOF128 is shown in Figure 7.

This mode comprises three main steps: initialization, absorbing the message, and squeezing the output. The length of the output L is 256 for Ascon-Hash256 and L > 0 for Ascon-
XOF128.

Note that the rate and capacity of Ascon-Hash256 are 64 and 256 bits, respectively.

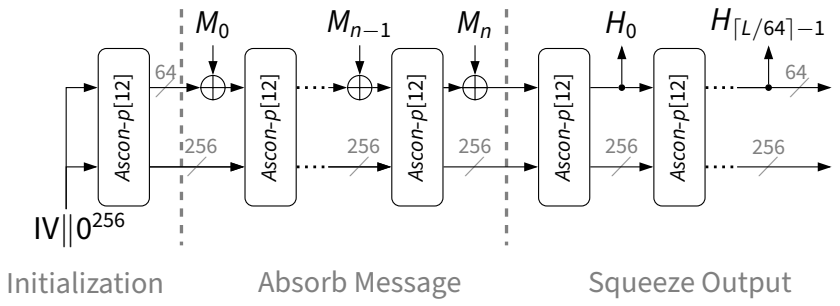
[picture p42: figure]
256 Ascon⁻p[12]; Initialization; Ascon-p[12]; Absorb Message; Squeeze Output

## Figure 7. Structure of Ascon-Hash256 and Ascon-XOF128

### August 2025

Standards for Constrained Devices

Ascon-Hash256 takes a variable length message M as input and produces a 256-bit digest. The full specification of Ascon-Hash256 can be found in Algorithm 5 and operates as follows:
1. Initialization. The 320-bit internal state of Ascon-Hash256 is initialized with the concatenation of the 64-bit IV = 0x0000080100cc0002 and 256 zeroes, followed by the Ascon-p[12] permutation as

S ← Ascon-p[12](IV ∥0
256). | (54)
2. Absorbing the message. The absorbing phase behaves similarly to the associated data processing of Ascon-AEAD128. The message is parsed into blocks, as

M0

,…,Mn−1,M̃n ← parse(M, 64), | (55)

where |Mi

| = 64 bits for 0 ≤ i ≤ n − 1 and 0 ≤ |M̃n| ≤ 63. The last block M̃n can be empty. Next, M̃n is padded to create a full block Mn:

Mn ← pad(M̃n, 64). | (56)

Each message block Mi
is XORed with the state as

S[0∶63] ← S[0∶63] ⊕Mi

. | (57)

For all message blocks except the final block Mn,the XOR operation is immediately followed by applying Ascon-p[12] to the state.

S ← Ascon-p[12](S) | (58)
3. Squeezing the hash. The squeezing phase begins after Mn is absorbed with an application of Ascon-p[12] to the state:
S ← Ascon-p[12](S). | (59)
The value of S[0∶63] is then taken as the 64-bit hash block Hi | , and the state is again
updated by Ascon-p[12]:
Hi ← S[0∶63] | (60)
S ← Ascon-p[12](S). | (61)

### August 2025

Standards for Constrained Devices

Steps (60) and (61) are repeated alternately until hash blocks H ,H , 0 | 1 | 2 and H have
been extracted. The final hash block is then extracted but is not followed by the Ascon-p[12] permutation:
H3 ← S[0∶63]. | | (62)

The resulting 256-bit digest is the concatenation of hash blocks as

H ← H0

∥H1

∥H2

∥H3
. | | (63)

## Algorithm 5 Ascon-Hash256(M)

Input: Bitstring M ∈ {0, 1}∗
Output: Digest H ∈ {0, 1}²⁵⁶
IV ←0x0000080100cc0002 | ▷ Initialization
S ← Ascon-p[12](IV ‖ 0²⁵⁶)

M0

,…,Mn−1,M̃n ← parse(M, 64) | | ▷ Absorbing
Mn ← pad(M̃n, 64)
for i = 0 to n − 1 do
S[0∶63] ← S[0∶63] ⊕Mi
S ← Ascon-p[12](S)
end for
S[0∶63] ← S[0∶63] ⊕Mn
S ← Ascon-p[12](S) | | ▷ Squeezing
for i = 0 to 2 do
Hi ← S[0∶63]
S ← Ascon-p[12](S)
end for
H3 ← S[0∶63]

H ← H0

‖H1

‖H2

‖H3
return H

### 5.2. Specification of Ascon-XOF128

Ascon-XOF128 is similar to Ascon-Hash256 but differs in three aspects:

1. Ascon-XOF128 accepts an additional input L > 0, which specifies the desired output

length in bits.

2. The number of blocks that are squeezed is ⌈L/64⌉.

### August 2025

Standards for Constrained Devices

3. The initial values used in Ascon-XOF128 and Ascon-Hash256 are different.

The 128 in the name Ascon-XOF128 refers to the target security strength, not the output size. Note that the rate and capacity of Ascon-XOF128 are 64 and 256 bits, respectively.

Ascon-XOF128 is specified by Algorithm 6 and is described as follows:

1. Initialization. The 320-bit internal state of Ascon-XOF128 is initialized with the concatenation of the 64-bit IV = 0x0000080000cc0003 and 256 zeroes, followed by the Ascon-p[12] permutation:

S ← Ascon-p[12](IV ∥0
256). | (64)
2. Absorbing the message. The absorbing phase behaves the same as that of Ascon-Hash256. The message is parsed into blocks as

M0

,…,Mn−1,M̃n ← parse(M, 64). | (65)

where |Mi

| = 64 bits for 0 ≤ i ≤ n − 1 and 0 ≤ |M̃n| ≤ 63. Partial block M̃n is then padded to a full block Mn as

Mn ← pad(M̃n, 64). | (66)

Each message block Mi
is absorbed by XORing the block into the state as

S[0∶63] ← S[0∶63] ⊕Mi

. | (67)

For all message blocks except the final block, the XOR operation is immediately followed by an application of Ascon-p[12] to the state:

S ← Ascon-p[12](S). | (68)
3. Squeezing the outputs. To obtain the requested L output bits, ℎ = ⌈L/64⌉ blocks must be extracted from the state. The squeezing phase begins with an application of Ascon-p[12] to the state:
S ← Ascon-p[12](S). | (69)

The value of S[0∶63] is then taken as output block Hi , and the state is again updated by Ascon-p[12]:
Hi ← S[0∶63] | (70)
S ← Ascon-p[12](S). | (71)

### August 2025

Standards for Constrained Devices

Steps (70) and (71) are repeated alternately until output blocks H0

,…,Hℎ−1 have
been squeezed. The final block is then squeezed without an additional permutation call:
Hℎ ← S[0∶63]. | (72)

Finally, the output blocks are concatenated, and the first L bits are returned as output H:
H′ ← H0
∥… ∥Hℎ | (73)

H ← H′
[0∶L−1]. | (74)

## Algorithm 6 Ascon-XOF128(M, L)

Input: Bitstring M ∈ {0, 1}∗
, output length L > 0
Output: Digest H ∈ {0, 1}L
IV ← 0x0000080000cc0003 | ▷ Initialization
S ← Ascon-p[12](IV ‖ 0²⁵⁶)

M0

,…,Mn−1,M̃n ← parse(M, 64) | ▷ Absorbing
Mn ← pad(M̃n, 64)
for i = 0 to n − 1 do
S[0∶63] ← S[0∶63] ⊕Mi
S ← Ascon-p[12](S)
end for
S[0∶63] ← S[0∶63] ⊕Mn
S ← Ascon-p[12](S) | ▷ Squeezing
ℎ ← ⌈L/64⌉ − 1
for i = 0 to ℎ − 1 do
Hi ← S[0∶63]
S ← Ascon-p[12](S)
end for
Hℎ ← S[0∶63]

H′ ← H0
‖… ‖Hℎ
H ← H′
[0∶L−1]
return H

### August 2025

Standards for Constrained Devices

### 5.3. Specification of Ascon-CXOF128

This section defines Ascon-CXOF128, which is a customized variant of Ascon-XOF128 that extends its functionality by incorporating a user-defined customization string. This feature enables domain separation, ensuring that two instances of Ascon-CXOF128 with the same input message but different customization strings produce distinct outputs.
In addition to the message M and output length L, Ascon-CXOF128 takesthe customization string Z as input. After initialization, the length of Z, in bits, is assigned to the 64-bit block Z0
as
Z0 = int64(|Z|). | (75)

Then, Z is parsed into blocks as

Z1

,…,Zm−1,Z̃m ← parse(Z, 64), | (76)

where |Zi

| = 64 bits for 0 ≤ i ≤ m − 1 and 0 ≤ |Z̃m| ≤ 63. The partial block Z̃m is then padded to a full block Zm as
Zm ← pad(Z̃m, 64). | (77)

The customization string Z is prepended to the message blocks as

Z0

∥Z1

∥… ∥Zm ∥M0

∥… ∥Mn−1 ∥Mn, | (78)

where the message blocks are generated similarly as in Ascon-XOF128.

Although similar to Ascon-XOF128, Ascon-CXOF128 uses a different IV. Hence, the concatenation of the customization string and the message produces different outputs for Ascon-
XOF128 and Ascon-CXOF128. The IV for Ascon-CXOF128 is 0x0000080000cc0004.

The general structure for Ascon-CXOF128 is shown in Figure 8 and the full specification is

provided in Algorithm 7.

The length of the customization string shall be at most 2048 bits (i.e., 256 bytes).

### August 2025

Standards for Constrained Devices

## Algorithm 7 Ascon-CXOF128(M, L, Z)

Input: Bitstring M ∈ {0, 1}∗

, output length L > 0, customization string Z ∈ {0, 1}∗ , where
|Z| ≤ 2048
Output: Digest H ∈ {0, 1}L
IV ← 0x0000080000cc0004 | ▷ Initialization
S ← Ascon-p[12](IV ‖0

256)

Z0 ← int64(|Z|) | ▷ Customization
Z1 …,Zm−1,Z̃m ← parse(Z, 64)
Zm ← pad(Z̃m, 64)
for i = 0 to m do
S[0∶63] ← S[0∶63] ⊕ Zi
S ← Ascon-p[12](S)
end for

M0

,…,Mn−1,M̃n ← parse(M, 64) | ▷ Absorbing
Mn ← pad(M̃n, 64)
for i = 0 to n − 1 do
S[0∶63] ← S[0∶63] ⊕Mi
S ← Ascon-p[12](S)
end for
S[0∶63] ← S[0∶63] ⊕Mn
S ← Ascon-p[12](S) | ▷ Squeezing
ℎ ← ⌈L/64⌉ − 1
for i = 0 to ℎ − 1 do
Hi ← S[0∶63]
S ← Ascon-p[12](S)
end for
Hℎ ← S[0∶63]

H′ ← H0
‖…‖Hℎ
H ← H′
[0∶L−1]
return H

### August 2025

Standards for Constrained Devices

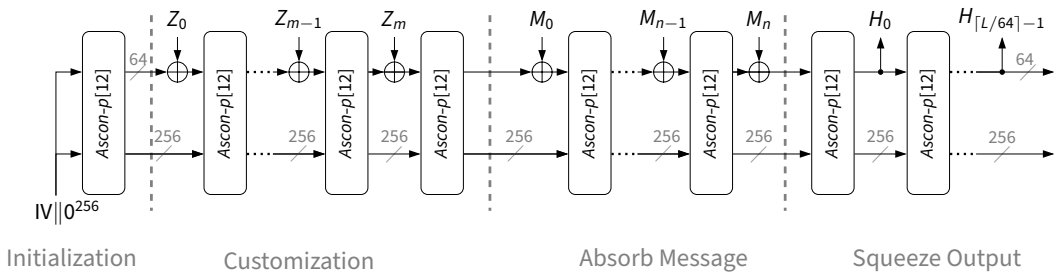
[picture p43: figure]
256 Ascon⁻p[12]; Initialization; Ascon-p[12]; Customization; Absorb Message; Squeeze Output

## Figure 8. Structure of Ascon-CXOF128

### 5.4. Streaming API for XOF

Ascon-XOF128 and Ascon-CXOF128 support incremental processing of input data, without the prior knowledge of complete input or output lengths. This makes them suitable for applications where data is received or processed in blocks. In particular, when using Ascon-XOF128 and Ascon-CXOF128, it is not necessary to know the output length L at the time that the final block is squeezed.

The following three functions can be used to create incremental implementations for
Ascon-XOF128.

## - ctx ← Ascon-XOF128.Init()

Initializes and returns Ascon-XOF128 context ctx.
Restriction: Must be called exactly once before any call to Absorb or Squeeze.
- ctx ← Ascon-XOF128.Absorb(ctx, str)
Absorbs an arbitrary-length input str into the state and updates the context ctx. Restriction: May be called multiple times after Init, but cannot be called after any call to Squeeze.
- (ctx, out) ← Ascon-XOF128.Squeeze(ctx, L)
Extracts L output bits produced during the squeezing phase of Ascon-XOF128 and updates context ctx.
Restriction: May be called multiple times after the absorb phase is complete, but must not be called before Init. The first call of Squeeze handles the padding of the final message block. Once Squeeze is called, no further calls to Absorb are

permitted.

These functions perform buffering of partial blocks, allowing both input and output to be processed in arbitrary-length segments. Therefore, these functions can then be used to begin execution without knowing the complete message M at the start of the absorption phase or the value L at the time that the final block is squeezed. This API is similar to those proposed for SHAKE-128 and SHAKE-256 in [22]. Similar interfaces can be defined for incremental implementations of Ascon-AEAD128 and Ascon-Hash256.

### August 2025

Standards for Constrained Devices

### 5.5. Security Strengths

## The security strengths of Ascon-Hash256, Ascon-XOF128, and Ascon-CXOF128 are sum-

marized in Table 9.

## Table 9. Security strengths of Ascon-Hash256, Ascon-XOF128, and Ascon-CXOF128

algorithms

Function | Output size in bits | Security strength in bits
Collision | Preimage | 2nd Preimage
Ascon-Hash256 | 256 | 128 | 128 | 128
Ascon-XOF128 | L | min(L/2,128) | min(L,128) | min(L,128)
Ascon-CXOF128 | L | min(L/2,128) | min(L,128) | min( ,128) L

If the message is known to belong to a set M, the preimage resistance is also limited by the size of M. For more information about security strengths against preimage attacks in different scenarios, refer to [19, 23].

### 6. Conformance

## The implementations of Ascon-AEAD128, Ascon-Hash256, Ascon-XOF128, and Ascon-

CXOF128 may be tested for conformance to this standard under the Cryptographic Validation Program [24]. Example test vectors are available from the Cryptographic Algorithm Validation Program (CAVP) [25].
Ascon-Hash256 is an approved cryptographic hash function; however, its use within the Keyed-Hash Message Authentication Code (HMAC) is not approved in this standard. Similarly, the use of Ascon-XOF128and Ascon-CXOF128 within HMAC is not approved.

Ascon-XOF128 and Ascon-CXOF128 are approved XOFs, and their approved uses will be specified in other NIST publications. While some of these uses may overlap with those of approved hash functions, XOFs are not approved as hash functions.

The Ascon permutations, including variants with different numbers of rounds, may be approved for additional applications if corresponding modes of operation are developed and approved within a FIPS or a NIST Special Publication.

### August 2025

Standards for Constrained Devices

### References

[1] Dobraunig C, Eichlseder M, Mendel F, Schläffer M (2014) Ascon v1, Submission to Round 1 of the CAESAR competition. Available at https://competitions.cr.yp.to/round1/asconv1.pdf. (https://competitions.cr.yp.to/round1/asconv1.pdf)
[2] Dobraunig C, Eichlseder M, Mendel F, Schläffer M (2015) Ascon v1.1, Submission to Round 2 of the CAESAR competition. Available at https://competitions.cr.yp.to/round2/asconv11.pdf. (https://competitions.cr.yp.to/round2/asconv11.pdf)
[3] Dobraunig C, Eichlseder M, Mendel F, Schläffer M (2016) Ascon v1.2, Submission to Round 3 of the CAESAR competition. Available at https://competitions.cr.yp.to/round3/asconv12.pdf. (https://competitions.cr.yp.to/round3/asconv12.pdf)
[4] National Institute of Standards and Technology (Published 2001; Updated 2023) Advanced Encryption Standard (AES), FIPS 197. https://doi.org/10.6028/NIST.FIPS.197-u pd1. (https://doi.org/10.6028/NIST.FIPS.197-upd1)
[5] Dworkin MJ (2007) Recommendation for Block Cipher Modes of Operation: Galois/Counter Mode (GCM) and GMAC (National Institute of Standards and Technology), Report. DOI:10.6028/NIST.SP.800-38D (https://doi.org/10.6028/NIST.SP.800-38D)
[6] National Institute of Standards and Technology (2015) Secure Hash Standard (SHS) (U.S. Department of Commerce), Report. DOI:10.6028/NIST.FIPS.180-4 (https://doi.org/10.6028/NIST.FIPS.180-4)
[7] National Institute of Standards and Technology (2015) SHA-3 Standard: Permutation-Based Hash and Extendable-Output Functions(U.S. Department of Commerce), Report. DOI:10.6028/NIST.FIPS.202 (https://doi.org/10.6028/NIST.FIPS.202)
[8] Dobraunig C, Eichlseder M, Mendel F, Schläffer M (2021) Ascon v1.2, Submission to Final Round of the NIST Lightweight Cryptography project. Available at https: //csrc.nist.gov/CSRC/media/Projects/lightweight-cryptography/documents/finalist-r ound/updated-spec-doc/ascon-spec-final.pdf. (https://csrc.nist.gov/CSRC/media/Projects/lightweight-cryptography/documents/finalist-round/updated-spec-doc/ascon-spec-final.pdf)
[9] Sönmez Turan M, McKay KA, Çalık Ç, Chang D, Bassham I Lawrence E (2019) Status Report on the First Round of the NIST Lightweight Cryptography Standardization Process (National Institute of Standards and Technology), Report. DOI:10.6028/NIST.IR.8268 (https://doi.org/10.6028/NIST.IR.8268)
[10] Sönmez Turan M, McKay KA, Chang D, Çalık Ç, Bassham I Lawrence E, Kang J, Kelsey J (2021) Status Report on the Second Round of the NIST Lightweight Cryptography Standardization Process (National Institute of Standards and Technology), Report. DOI:10.6028/NIST.IR.8369 (https://doi.org/10.6028/NIST.IR.8369)
[11] Sönmez Turan M, McKay KA, Chang D, Bassham L, Kang J, Waller N, Kelsey J, Hong D (2023) Status Report on the Final Round of the NIST Lightweight Cryptography Standardization Process (National Institute of Standards and Technology), Report. DOI:10.6028/NIST.IR.8454 (https://doi.org/10.6028/NIST.IR.8454)
[12] Bellare M, Hoang VT (2022) Efficient Schemes for Committing Authenticated Encryption. Advancesin Cryptology - EUROCRYPT 2022 - 41st Annual International Conference on the Theory and Applications of Cryptographic Techniques, Trondheim, Norway, May 30 - June 3, 2022, Proceedings, Part II, eds Dunkelman O, Dziembowski S (Springer),

### August 2025

Standards for Constrained Devices

Lecture Notes in Computer Science, Vol. 13276, pp 845–875. DOI:10.1007/978-3-031-07085-3_29 (https://doi.org/10.1007/978-3-031-07085-3_29)
[13] Bellare M, Kohno T (2003) A Theoretical Treatment of Related-Key Attacks: RKA-PRPs, RKA-PRFs, and Applications. Advances in Cryptology - EUROCRYPT 2003, International Conference on the Theory and Applications of Cryptographic Techniques, Warsaw, Poland, May 4-8, 2003, Proceedings, ed Biham E (Springer), Lecture Notes in Computer Science, Vol. 2656, pp 491–506. DOI:10.1007/3-540-39200-9\_31. (https://doi.org/10.1007/3-540-39200-9_31) Available at https: //doi.org/10.1007/3-540-39200-9_31
[14] Dobraunig C, Mennink B (2024) Generalized Initialization of the Duplex Construction. Applied Cryptography and Network Security - 22nd International Conference, ACNS 2024, Abu Dhabi, United Arab Emirates, March 5-8, 2024, Proceedings, Part II, eds Pöpper C, Batina L (Springer), Lecture Notes in Computer Science, Vol. 14584, pp 460–484. DOI:10.1007/978-3-031-54773-7_18 (https://doi.org/10.1007/978-3-031-54773-7_18)
[15] Barker E, Roginsky A, Davis R (2020) Recommendation for Cryptographic Key Generation, (National Institute of Standards and Technology, Gaithersburg, MD), NIST Special Publication (SP) 800-133 Rev. 2. DOI:10.6028/NIST.SP.800-133r2. (https://doi.org/10.6028/NIST.SP.800-133r2)
[16] Chakraborty B, Dhar C, Nandi M (2023) Exact Security Analysis of ASCON. Advances in Cryptology - ASIACRYPT 2023 - 29th International Conference on the Theory and Application of Cryptology and Information Security, Guangzhou, China, December 4-8, 2023, Proceedings, Part III, eds Guo J, Steinfeld R (Springer), Lecture Notesin Computer Science, Vol. 14440, pp 346–369. DOI:10.1007/978-981-99-8727-6_12 (https://doi.org/10.1007/978-981-99-8727-6_12)
[17] Lefevre C, Mennink B (2025) Generic Security of the Ascon Mode: On the Power of Key Blinding. Selected Areas in Cryptography – SAC 2024, eds Eichlseder M, Gambs S (Springer Nature Switzerland, Cham), pp 3–32.
[18] Chakraborty B, Dhar C, Nandi M (2024) Tight Multi-user Security of Ascon and Its Large Key Extension. Information Security and Privacy - 29th Australasian Conference, ACISP 2024, Sydney, NSW, Australia, July 15-17, 2024, Proceedings, Part I, eds Zhu T, Li Y (Springer), Lecture Notesin Computer Science, Vol. 14895, pp 57–76. DOI:10.1007/978-981-97-5025-2_4 (https://doi.org/10.1007/978-981-97-5025-2_4)
[19] Lefevre C, Mennink B (2025) SoK: Security of the Ascon Modes. IACR Trans Symmetric Cryptol 2025(1):138–210. DOI:10.46586/TOSC.V2025.I1.138-210. (https://doi.org/10.46586/TOSC.V2025.I1.138-210) Available at https: //doi.org/10.46586/tosc.v2025.i1.138-210
[20] Naito Y, Sasaki Y, Sugawara T (2023) Committing Security of Ascon: Cryptanalysis on Primitive and Proof on Mode. IACR Trans Symmetric Cryptol 2023(4):420–451. DOI:10.46586/TOSC.V2023.I4.420-451. (https://doi.org/10.46586/TOSC.V2023.I4.420-451) Available at https://doi.org/10.46586/tosc.v2 023.i4.420-451 (https://doi.org/10.46586/tosc.v2023.i4.420-451)
[21] Krämer J, Struck P, Weishäupl M (2024) Committing AE from Sponges Security Analysis of the NIST LWC Finalists. IACR Trans Symmetric Cryptol 2024(4):191–248. DOI:10.46586/TOSC.V2024.I4.191-248. (https://doi.org/10.46586/TOSC.V2024.I4.191-248) Available at https://doi.org/10.46586/tosc.v2 024.i4.191-248 (https://doi.org/10.46586/tosc.v2024.i4.191-248)
[22] National Institute of Standards and Technology (2024) Module-Lattice-Based Key-Encapsulation Mechanism Standard (U.S. Department of Commerce, Washing-

### August 2025

Standards for Constrained Devices

ton, D.C.), Federal Information Processing Standards Publications (FIPS) 203. DOI:10.6028/NIST.FIPS.203 (https://doi.org/10.6028/NIST.FIPS.203)
[23] Lefevre C, Mennink B (2022) Tight Preimage Resistance of the Sponge Construction. Advances in Cryptology - CRYPTO 2022 - 42nd Annual International Cryptology Conference, CRYPTO 2022, Santa Barbara, CA, USA, August 15-18, 2022, Proceedings, Part IV, eds Dodis Y, Shrimpton T (Springer), Lecture Notes in Computer Science, Vol. 13510, pp 185–204. DOI:10.1007/978-3-031-15985-5\_7. (https://doi.org/10.1007/978-3-031-15985-5_7) Available at https://doi.org/10.1007/978-3-031-15985-5_7
[24] National Institute of Standards and Technology (2024) Cryptographic Module Validation Program (CMVP). Available at https://csrc.nist.gov/projects/cryptographic-mod ule-validation-program. (https://csrc.nist.gov/projects/cryptographic-module-validation-program)
[25] National Institute of Standards and Technology (2023) GitHub repository usnistgov/ACVP-Server: Automated Cryptographic Validation Test System — Gen/Vals). Available at https://github.com/usnistgov/ACVP-Server/tree/master/gen-val/json-files.

### August 2025

Standards for Constrained Devices

### Appendix A. Implementation Notes

This specification follows the little-endian ordering convention. That is, on little-endian machines, byte strings or words of any size can be loaded from memory directly into the Ascon state without the need to perform any conversion. Neither bytes nor bits need to be reversed. The hexadecimal forms of the padding for Ascon functions are described in Sec. A.2.

However, the convention for printing the Ascon state using 64-bit integer words in hexadecimal notation (most significant byte and bit first) is different from printing the Ascon state using byte sequences or bitstrings (least significant byte and bit first). The conversion functions between printing byte sequences and printing integers are specified in Sec. A.1.

The least significant bit of S0

is s(0,0) (i.e., S[0∶0]), and the most significant bit of S4

is s(4,63)
(i.e., S[319∶319]). Similarly, the least significant byte of S0 is the first byte of state (S[0∶7]), and the most significant byte of S4
is the last byte of the state (S[312∶319]). This relationship between state words, bytes, and state bits is shown in Fig. 9, where Si

[j] denotes the j

tℎ
byte of state word Si

for 0 ≤ i ≤ 4 and 0 ≤ j ≤ 7.

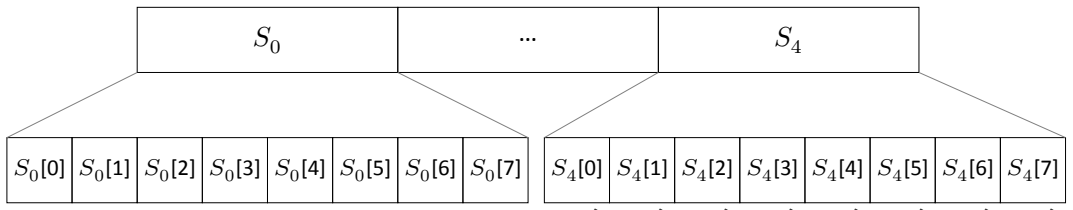
[picture p44: figure]

Figure 9. Mapping between state words, bytes, and bits

S[0∶7]

S[8∶15]

S[16∶23]

S[24∶31]

S[32∶39]

S[40∶47]
S[48∶55]
S[56∶63]

S[256∶263]

S[264∶271]

S[272∶279]
S[280∶287]
S[288∶295]

S[296∶303]

S[304∶311]

S[312∶319]

A.1. Conversion Functions

When printing values as integers using hexadecimal notation, the most significant byte and most significant bit are shown first.

Integers and byte sequences. Printing the integer representation of a byte sequence requires the byte order to be reversed. That is, the first element in the sequence of bytes is the least significant byte of the integer, while the last element in the sequence of bytes is the most significant byte of the integer.

Integers and bitstrings. Printing a bitstring as an integer requiresthe byte order and the bits within a byte to be reversed. That is, the first element of a bitstring is the least significant bit of the integer (or byte), while the last element of the bitstring is the least significant bit of the integer (or byte).

### August 2025

Standards for Constrained Devices

Loading 64-bit integer words from a byte sequence. When loading the state from a sequence of bytes stored in memory, the first eight bytes are mapped to the first 64-bit unsigned integer word S0
in little-endian notation (i.e., without byte reversal on little-endian machines). The next eight bytes are loaded to S1
. Bytes continue to be loaded in the same way until the final eight bytes of the stored state are loaded into S4

An example of the mapping between memory addresses to state word bytes is presented in Table 10 for both little-endian and big-endian machines. An example of mappings between 64-bit unsigned integers, byte sequences, and bitstrings is shown in Fig. 10. Note that 64-bit integers and bitstrings only appear to be reversed in the visual representation.

Table 10. Address for each byte of Ascon state word Si
in memory on little-endian and big-endian machines, where the word Si begins at memory address a

Word
byte

Little-endian
address

Big-endian
address
Si
[0] | a + 0 | a + 7
Si
[1] | a + 1 | a + 6
Si
[2] | a + 2 | a + 5
Si
[3] | a + 3 | a + 4
Si
[4] | a + 4 | a + 3
Si
[5] | a + 5 | a + 2
Si
[6] | a + 6 | a + 1
Si
[7] | a + 7 | a + 0

Writing 64-bitinteger wordsto a byte sequence. The processfor writing the 64-bit unsigned integer Ascon state words to a byte sequence in memory is simply the reverse of loading a state word from a byte sequence. The byte order does not need to be reversed on little-endian machines.

A.2. Implementing with Integers

This section provides additional information for software implementations that employ 64-bit unsigned integers.

Padding. The padding rule described in Algorithm 2 appends a one followed by one or more zeroes to data. For an integer x that can be represented with n < 8 bytes, an integer y that represents a padded version of x is computed as

y ← x ⊕ (0x0000000000000001 ≪ 8n).

### August 2025

Standards for Constrained Devices

Figure 10. Representation of the Ascon state as 64-bit unsigned integers, byte sequences, and bitstrings, where 64-bit unsigned integers are used to define the permutation, data stored in memory is represented as byte sequences, and bitstrings are used to specify the modes of operation. Note that 64-bit integers and bitstrings only appear to be reversed in the visual representation.

State bits | State word | Word value (64-bit unsigned integers)
S[0∶63] | S0 | 0x0706050403020100
S[64∶127] | S1 | 0x0F0E0D0C0B0A0908
S[128∶191] | S2 | 0x1716151413121110
S[192∶255] | S3 | 0x1F1E1D1C1B1A1918
S[256∶319] | S4 | 0x2726252423222120
↕
State bits | State word | Word value (byte sequence)
S[0∶63] | S0 | 0x00 0x01 0x02 0x03 0x04 0x05 0x06 0x07
S[64∶127] | S1 | 0x08 0x09 0x0A 0x0B 0x0C 0x0D 0x0E 0x0F
S[128∶191] | S2 | 0x10 0x11 0x12 0x13 0x14 0x15 0x16 0x17
S[192∶255] | S3 | 0x18 0x19 0x1A 0x1B 0x1C 0x1D 0x1E 0x1F
S[256∶319] | S4 | 0x20 0x21 0x22 0x23 0x24 0x25 0x26 0x27
↕
State bits | State word | Word value (bitstring)
S[0∶63] | S0 | 0000 0000 1000 0000 0100 0000 1100 0000 0010 0000 1010 0000 0110 0000 1110 0000
S[64∶127] | S1 | 0001 0000 1001 0000 0101 0000 1101 0000 0011 0000 1011 0000 0111 0000 1111 0000
S[128∶191] | S2 | 0000 1000 1000 1000 0100 1000 1100 1000 0010 1000 1010 1000 0110 1000 1110 1000
S[192∶255] | S3 | 0001 1000 1001 1000 0101 1000 1101 1000 0011 1000 1011 1000 0111 1000 1111 1000
S[256∶319] | S4 | 0000 0100 1000 0100 0100 0100 1100 0100 0010 0100 1010 0100 0110 0100 1110 0100

### August 2025

Standards for Constrained Devices

Table 11. Examples of padding an unsigned integer x to a 64-bit block, where x encodes a sequence of bytes that each have value 0xFF in little-endian byte order

Length of x (in bytes) | # Padding Bytes | Unsigned integer x | Padded 64-bit block
0 | 8 | 0x0000000000000000 | 0x0000000000000001
1 | 7 | 0x00000000000000FF | 0x00000000000001FF
2 | 6 | 0x000000000000FFFF | 0x000000000001FFFF
3 | 5 | 0x0000000000FFFFFF | 0x0000000001FFFFFF
4 | 4 | 0x00000000FFFFFFFF | 0x00000001FFFFFFFF
5 | 3 | 0x000000FFFFFFFFFF | 0x000001FFFFFFFFFF
6 | 2 | 0x0000FFFFFFFFFFFF | 0x0001FFFFFFFFFFFF
7 | 1 | 0x00FFFFFFFFFFFFFF | 0x01FFFFFFFFFFFFFF

Domain separation bit. The hexadecimal integer form of the domain separation bit is 0x8000000000000000. Therefore, the addition of this bit into the state may be imple-

mented as
S4 ← S4 ⊕0x8000000000000000.

## 64-bit block absorption. In Ascon-Hash256, Ascon-XOF128, or Ascon-CXOF128, the

absorption of a 64-bit message block expressed as the byte sequence 0x00, 0x01, 0x02, 0x03, 0x04, 0x05, 0x06, 0x07 can be implemented as
S0 ← S0 ⊕0x0706050403020100.

128-bit block absorption. Absorbing a 128-bit associated data or plaintext block represented
by byte sequence 0x00, 0x01, 0x02, 0x03, 0x04, 0x05, 0x06, 0x07, 0x08, 0x09, 0x0A,
0x0B, 0x0C, 0x0D, 0x0E, 0x0F can similarly be implemented as

## S0 ← S0 ⊕0x0706050403020100

S1 ← S1 ⊕0x0F0E0D0C0B0A0908.

Key addition. Ascon-AEAD128 has keyed initialization and finalization, where the key is added to the state in various locations. For a key represented as a sequence of bytes with
value 0x00, 0x01, 0x02, 0x03, 0x04, 0x05, 0x06, 0x07, 0x08, 0x09, 0x0A, 0x0B, 0x0C,
0x0D, 0x0E, 0x0F, the key addition at the beginning of the initialization phase may be

written as

## S1 ← S1 ⊕0x0706050403020100

S2 ← S2 ⊕0x0F0E0D0C0B0A0908.

### August 2025

Standards for Constrained Devices

The key addition at the end of the initialization phase may be written as

## S3 ← S3 ⊕0x0706050403020100

S4 ← S4 ⊕0x0F0E0D0C0B0A0908.

The key addition at the beginning of the finalization phase can be expressed as:

## S2 ← S2 ⊕0x0706050403020100

S3 ← S3 ⊕0x0F0E0D0C0B0A0908.

The key addition at the end of finalization can be implemented as

## S3 ← S3 ⊕0x0706050403020100

S4 ← S4 ⊕0x0F0E0D0C0B0A0908.

A.3. Precomputation

## The initialization phases of Ascon-Hash256, Ascon-XOF128, and Ascon-CXOF128 are in-

dependent of the input data (e.g., message, output length, customization string), allowing the resulting internal state to be precomputed to reduce runtime computations. See Table 12 for the resulting state at the end of the initialization phase for each function.
For example, an implementation of Ascon-Hash256 using the precomputed values would replace the first two steps of Alg. 5

## IV ← 0x0000080100cc0002

S ← Ascon-p[12](IV ∥ 0²⁵⁶)

with steps that assign each of the precomputed words into the corresponding state words, namely:

## S0 ← 0x9b1e5494e934d681 S1 ← 0x4bc3a01e333751d2 S2 ← 0xae65396c6b34b81a S3 ← 0x3c7fd4a4d56a4db3

S4 ← 0x1a5c464906c5976d.

The same is true for Ascon-XOF128 and Ascon-CXOF128 using the corresponding values

given in Table 12.

It may also be beneficial to precompute the intermediate state between the customization and absorbing phases when Ascon-CXOF128 repeatedly uses the same customization

string.

### August 2025

Standards for Constrained Devices

Table 12. Precomputed initialization phase values for Ascon-Hash256, Ascon-XOF128, and Ascon-CXOF128 provided in hexadecimal integer form

State word | Ascon-Hash256 | Ascon-XOF128 | Ascon-CXOF128
S0 | 0x9b1e5494e934d681 | 0xda82ce768d9447eb | 0x675527c2a0e8de03
S1 | 0x4bc3a01e333751d2 | 0xcc7ce6c75f1ef969 | 0x43d12d7dc0377bbc
S2 | 0xae65396c6b34b81a | 0xe7508fd780085631 | 0xe9901dec426e81b5
S3 | 0x3c7fd4a4d56a4db3 | 0x0ee0ea53416b58cc | 0x2ab14907720780b6
S4 | 0x1a5c464906c5976d | 0xe0547524db6f0bde | 0x8f3f1d02d432bc46

### Appendix B. Determination of the Initial Values

Each variant of the Ascon family has a 64-bit initial value constructed as

IV = v ∥0
8

∥ a ∥ b ∥ t ∥r/8 ∥0
16
, | (79)

where

- v is a unique identifier for the algorithm (represented in 8 bits)
- a isthe number of rounds during initialization and finalization (represented in 4 bits)
- b is the number of rounds during the processing of AD, plaintext, and ciphertext for

## Ascon-AEAD128 and the message for Ascon-Hash256, Ascon-XOF128, and Ascon-

CXOF128 (represented in 4 bits)

## - t is 128 for Ascon-AEAD128, 256 for Ascon-Hash256, and 0 for Ascon-XOF128 and

Ascon-CXOF128 (represented in 16 bits)

- r/8 is the number of input bytes processed per invocation of the underlying permutation (represented in 8 bits)

The values of these parameters for each variant are given in Table 13, and the initial values for each Ascon variant are specified in Table 14.

Table 13. Parameters for initial value construction

Ascon variants | v
| (8 bits) | a
| | (4 bits) | b
| | | (4 bits) | t
| | | | (16 bits) | r/8
| | | | | (8 bits)
Ascon-AEAD128 | 1 | 12 | 8 | 128 | 16
Ascon-Hash256 | 2 | 12 | 12 | 256 | 8
Ascon-XOF128 | 3 | 12 | 12 | 0 | 8
Ascon-CXOF128 | 4 | 12 | 12 | 0 | 8

### August 2025

Standards for Constrained Devices

Table 14. Initial values as hexadecimal integers

Ascon variants | Initial value

## Ascon-AEAD128 0x00001000808c0001 Ascon-Hash256 0x0000080100cc0002 Ascon-XOF128 0x0000080000cc0003 Ascon-CXOF128 0x0000080000cc0004
