ShlomoAbrams/ascon/docs/cmos.webp

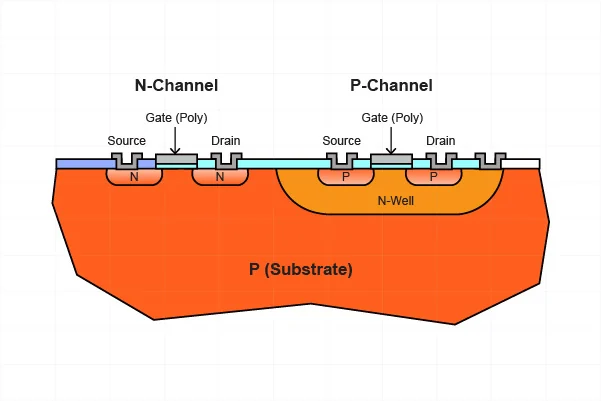
docs/cmos.webp
