ShlomoAbrams/ascon/docs/Cross_section_of_a_CMOS_inverter.svg.webp

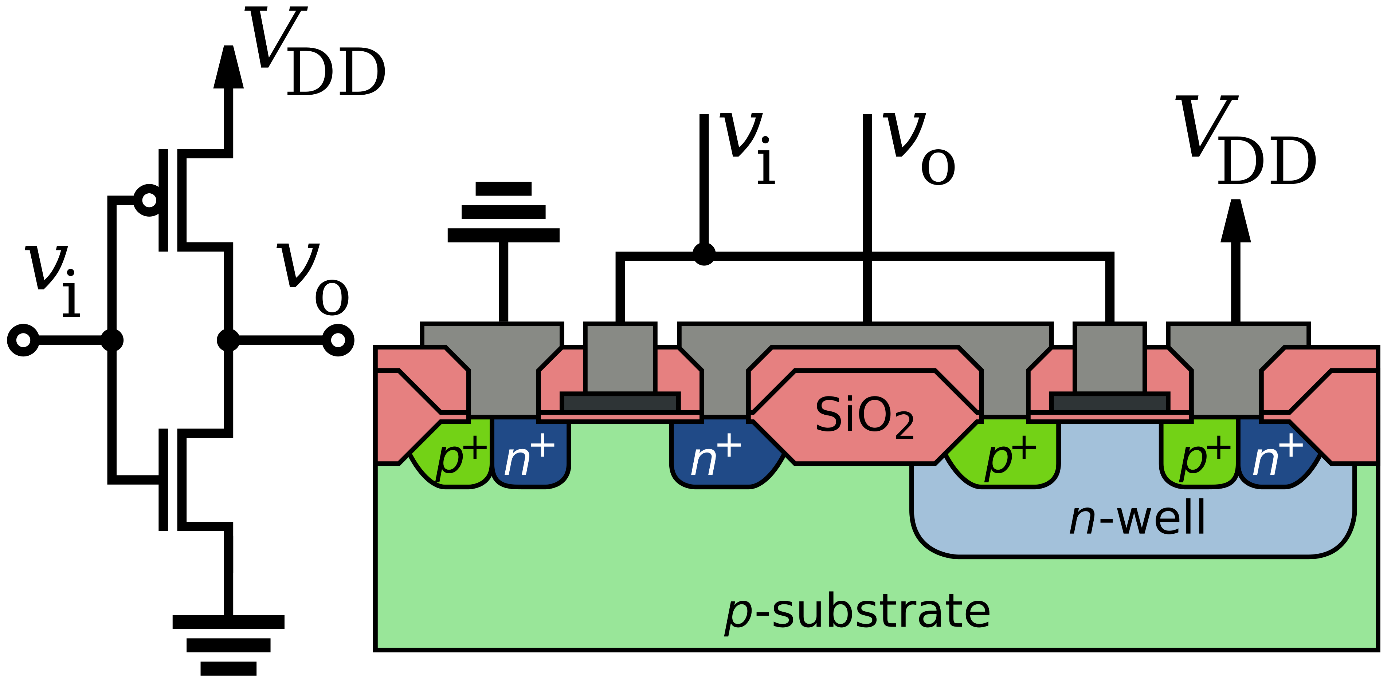
docs/Cross_section_of_a_CMOS_inverter.svg.webp
