ShlomoAbrams/ascon/docs/layout-of-inverter-l.webp

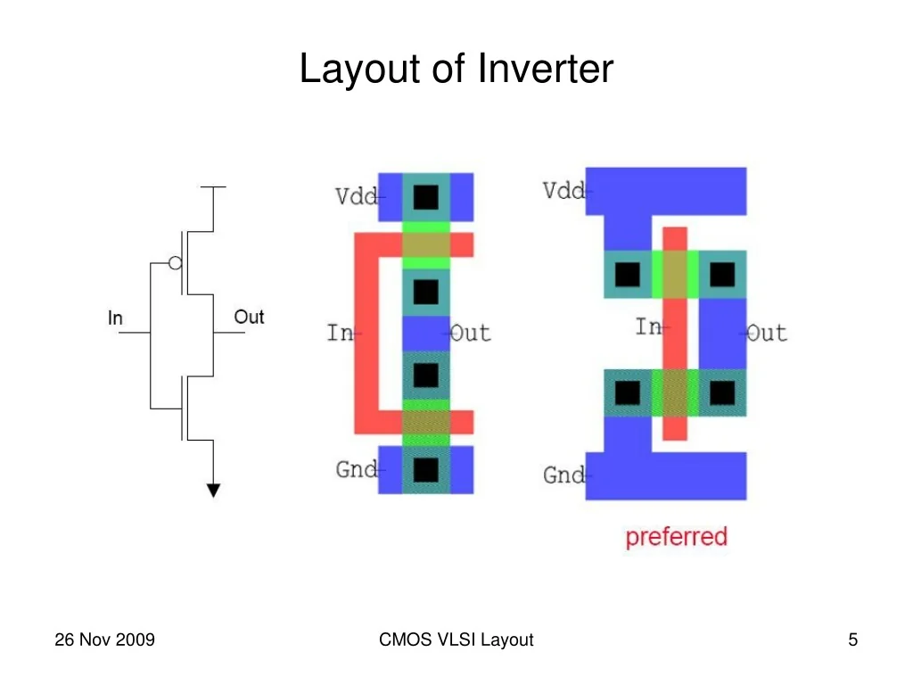
docs/layout-of-inverter-l.webp
