ShlomoAbrams/ascon/rpi/rpi_test.py

#!/usr/bin/env python3
"""
================================================================================
Raspberry Pi Hardware-in-the-Loop Testbench for Basys 3 Ascon-128 Accelerator
================================================================================

This script runs on a Raspberry Pi connected via jumper wires to a Digilent Basys 3
FPGA running the Ascon-128 AEAD bitstream (`basys3_ascon_top.v`).

WIRING TABLE (Raspberry Pi 40-Pin Header <---> Basys 3 PMOD Headers):
Parallel Rails Layout (JB -> JC -> JA, with USB ports oriented at TOP):
- OUTER ROW (Even pins 2..40: LEFT column / outer board edge): 5-wire bundles (Signals + GND)
- INNER ROW (Odd pins 1..39: RIGHT column / toward CPU): 4-wire bundles (Signals only)
- Orientation: Top = USB Ports (Pins 39/40), Bottom = MicroSD Slot (Pins 1/2)
- Zone Order: Top = PMOD JB (Read Bus), Middle = PMOD JC (Address/Control), Bottom = PMOD JA (Write Bus)
--------------------------------------------------------------------------------
Signal Name | Direction (from RPi) | Wire Color | RPi BCM GPIO | RPi Physical Pin | Basys 3 PMOD Pin
--------------------------------------------------------------------------------
PMOD JB: Read Data Bus (uo_out[7:0] - RPi Inputs from FPGA) [Top Zone]
-- JB Top (5-wire bundle: Pins 40, 38, 36, 34[GND], 32) --
rdata[0]    | Input                | Black      | GPIO 21      | Pin 40           | JB1 (A14)
rdata[1]    | Input                | White      | GPIO 20      | Pin 38           | JB2 (A16)
rdata[2]    | Input                | Gray       | GPIO 16      | Pin 36           | JB3 (B15)
GND         | Ground Reference     | Blue       | GND          | Pin 34           | JB5 (GND)
rdata[3]    | Input                | Purple     | GPIO 12      | Pin 32           | JB4 (B16)
-- JB Bottom (4-wire bundle: Pins 35, 33, 31, 29) --
rdata[4]    | Input                | Brown      | GPIO 19      | Pin 35           | JB7 (A15)
rdata[5]    | Input                | Red        | GPIO 13      | Pin 33           | JB8 (A17)
rdata[6]    | Input                | Orange     | GPIO 6       | Pin 31           | JB9 (C15)
rdata[7]    | Input                | Yellow     | GPIO 5       | Pin 29           | JB10 (C16)
--------------------------------------------------------------------------------
PMOD JC: Control & Address Bus (uio_in[7:0] - RPi Outputs to FPGA) [Middle Zone]
-- JC Top Row (5-wire bundle: Pins 26, 24, 22, 20[GND], 18) --
addr[0]     | Output               | Black      | GPIO 7       | Pin 26           | JC1 (K17)
addr[1]     | Output               | White      | GPIO 8       | Pin 24           | JC2 (M18)
addr[2]     | Output               | Gray       | GPIO 25      | Pin 22           | JC3 (N17)
GND         | Ground Reference     | Blue       | GND          | Pin 20           | JC5 (GND)
addr[3]     | Output               | Purple     | GPIO 24      | Pin 18           | JC4 (P18)
-- JC Bottom Row (4-wire bundle: Pins 21, 19, 15, 13) --
bank        | Output               | Brown      | GPIO 9       | Pin 21           | JC7 (L17)  [uio[4]]
read_tag    | Output               | Red        | GPIO 10      | Pin 19           | JC8 (M19)  [uio[5]]
write_raw   | Output (Write Strobe)| Orange     | GPIO 22      | Pin 15           | JC9 (P17)  [uio[6]]
unused      | Output (Tied low 0)  | Yellow     | GPIO 27      | Pin 13           | JC10 (R18) [uio[7]]
--------------------------------------------------------------------------------
PMOD JA: Write Data Bus (ui_in[7:0] - RPi Outputs to FPGA) [Bottom Zone]
-- JA Top (5-wire bundle: Pins 16, 14[GND], 12, 10, 8) --
wdata[0]    | Output               | Black      | GPIO 23      | Pin 16           | JA1 (J1)
GND         | Ground Reference     | Blue       | GND          | Pin 14           | JA5 (GND)
wdata[1]    | Output               | White      | GPIO 18      | Pin 12           | JA2 (L2)
wdata[2]    | Output               | Gray       | GPIO 15      | Pin 10           | JA3 (J2)
wdata[3]    | Output               | Purple     | GPIO 14      | Pin 8            | JA4 (G2)
-- JA Bottom (4-wire bundle: Pins 11, 7, 5, 3) --
wdata[4]    | Output               | Brown      | GPIO 17      | Pin 11           | JA7 (H1)
wdata[5]    | Output               | Red        | GPIO 4       | Pin 7            | JA8 (K2)
wdata[6]    | Output               | Orange     | GPIO 3       | Pin 5            | JA9 (H2)
wdata[7]    | Output               | Yellow     | GPIO 2       | Pin 3            | JA10 (G3)
================================================================================
"""

import sys
import time
import argparse
import random

# Check for Raspberry Pi hardware environment
try:
    import RPi.GPIO as GPIO
    HARDWARE_AVAILABLE = True
except (ImportError, RuntimeError):
    HARDWARE_AVAILABLE = False


# ==============================================================================
# Pin Definitions (Broadcom / BCM Numbering) - Clean Parallel Rails (JB -> JC -> JA)
# ==============================================================================
# PMOD JB: Read Data Bus (Top Zone, near Pin 40)
# JB Top (5-wire bundle with GND): Pins 40, 38, 36, 32 (GND on Pin 34)
# JB Bottom (4-wire bundle): Pins 35, 33, 31, 29
PIN_RDATA = [21, 20, 16, 12, 19, 13, 6, 5]   # rdata[0..7]

# PMOD JC: Control & Address Bus (Middle Zone)
# JC Top (5-wire bundle with GND): Pins 26, 24, 22, 18 (GND on Pin 20)
PIN_ADDR      = [7, 8, 25, 24]  # JC1 (GPIO 7), JC2 (GPIO 8), JC3 (GPIO 25), JC4 (GPIO 24)

# PMOD JC Bottom Row: Bank, Read Tag, Write Strobe, Unused (4-wire bundle: Pins 21, 19, 15, 13)
PIN_BANK      = 9    # JC7:  Pin 21 (GPIO 9)  - uio[4] (0: Buffer, 1: Control)
PIN_READ_TAG  = 10   # JC8:  Pin 19 (GPIO 10) - uio[5] (1: Read 128-bit Tag)
PIN_WRITE_RAW = 22   # JC9:  Pin 15 (GPIO 22) - uio[6] (Rising-edge write strobe)
PIN_UNUSED    = 27   # JC10: Pin 13 (GPIO 27) - uio[7] (Tied to 0)

# PMOD JA: Write Data Bus (Bottom Zone, near Pin 1)
# JA Top (5-wire bundle with GND): Pins 16, 12, 10, 8 (GND on Pin 14)
# JA Bottom (4-wire bundle): Pins 11, 7, 5, 3
PIN_WDATA = [23, 18, 15, 14, 17, 4, 3, 2]  # wdata[0..7]


# ==============================================================================
# Mock Hardware Class (For testing without a physical Raspberry Pi)
# ==============================================================================
class MockAscon:
    """Simulates the Ascon hardware accelerator in software when running without GPIOs."""
    def __init__(self):
        self.buffer = bytearray(16)
        self.key = bytearray(16)
        self.nonce = bytearray(16)
        self.tag = bytes.fromhex("09bc056f68406a5a3ef6518eb967e09c")
        self.ct_mock = bytes.fromhex("91f5f635690000000000000000000000")
        self.fsm_state = "I_NONCE"

    def write(self, addr, data, bank):
        if bank == 0:
            self.buffer[addr & 0xF] = data & 0xFF
        else:
            load = data & 0x01
            if load:
                if self.fsm_state in ("I_NONCE", "FINISH"):
                    self.nonce = bytes(self.buffer)
                    self.fsm_state = "I_KEY"
                elif self.fsm_state == "I_KEY":
                    self.key = bytes(self.buffer)
                    self.fsm_state = "AD_LOAD"
                elif self.fsm_state == "AD_LOAD":
                    self.fsm_state = "PT_LOAD"
                elif self.fsm_state == "PT_LOAD":
                    self.buffer = bytearray(self.ct_mock)
                    self.fsm_state = "FINISH"

    def read(self, addr, bank, read_tag):
        if read_tag:
            return self.tag[addr & 0xF]
        if bank == 0:
            return self.buffer[addr & 0xF]
        else:
            # Status register at 0x10 (bank=1, addr=0)
            if self.fsm_state == "I_NONCE":
                return 0x01  # ready_for_nonce
            elif self.fsm_state == "I_KEY":
                return 0x02  # ready_for_key
            elif self.fsm_state == "AD_LOAD":
                return 0x04  # ready_for_ad
            elif self.fsm_state == "PT_LOAD":
                return 0x18  # ready_for_pt | ct_ready
            elif self.fsm_state == "FINISH":
                return 0x31  # finish_reg (0x20) | ct_ready (0x10) | ready_for_nonce (0x01)
            return 0x01


# ==============================================================================
# Hardware Controller Class
# ==============================================================================
class AsconTester:
    def __init__(self, mock=False, clock_delay=0.0001, step_delay=0.15):
        self.mock = mock
        self.clock_delay = clock_delay  # Strobe hold delay (seconds)
        self.step_delay = step_delay    # Visual pause between operations for LEDs (seconds)

        if self.mock:
            print("[INFO] Initialized in MOCK simulation mode (no hardware required).")
            self.sim = MockAscon()
        else:
            print("[INFO] Initialized in REAL HARDWARE mode (RPi.GPIO).")
            GPIO.setmode(GPIO.BCM)
            GPIO.setwarnings(False)

            # Setup Output pins (PMOD JA - Write Data)
            for pin in PIN_WDATA:
                GPIO.setup(pin, GPIO.OUT, initial=GPIO.LOW)

            # Setup Output pins (PMOD JC - Address & Control)
            for pin in PIN_ADDR:
                GPIO.setup(pin, GPIO.OUT, initial=GPIO.LOW)
            GPIO.setup(PIN_BANK,      GPIO.OUT, initial=GPIO.LOW)
            GPIO.setup(PIN_READ_TAG,  GPIO.OUT, initial=GPIO.LOW)
            GPIO.setup(PIN_WRITE_RAW, GPIO.OUT, initial=GPIO.LOW)
            GPIO.setup(PIN_UNUSED,    GPIO.OUT, initial=GPIO.LOW)

            # Setup Input pins (PMOD JB - Read Data)
            for pin in PIN_RDATA:
                GPIO.setup(pin, GPIO.IN)

    def cleanup(self):
        if not self.mock:
            GPIO.cleanup()

    # --- Low-Level Bus Operations ---
    def _set_address(self, addr, bank=0, read_tag=0):
        if not self.mock:
            for i in range(4):
                bit = (addr >> i) & 1
                GPIO.output(PIN_ADDR[i], bit)
            GPIO.output(PIN_BANK, bank & 1)
            GPIO.output(PIN_READ_TAG, read_tag & 1)
            GPIO.output(PIN_UNUSED, GPIO.LOW)

    def write_byte(self, addr, data, bank=0):
        """Presents data on JA, sets address on JC, and pulses write_raw across 2-FF sync."""
        val = data & 0xFF
        if self.mock:
            self.sim.write(addr, val, bank)
        else:
            self._set_address(addr, bank=bank, read_tag=0)
            for i in range(8):
                bit = (val >> i) & 1
                GPIO.output(PIN_WDATA[i], bit)
            # Pulse write_raw strobe
            time.sleep(self.clock_delay)
            GPIO.output(PIN_WRITE_RAW, GPIO.HIGH)
            time.sleep(self.clock_delay)
            GPIO.output(PIN_WRITE_RAW, GPIO.LOW)
        if self.step_delay > 0:
            time.sleep(self.step_delay)

    def read_byte(self, addr, bank=0, read_tag=0):
        """Sets address/mux select on JC and reads uo_out bus from JB."""
        if self.mock:
            val = self.sim.read(addr, bank, read_tag)
        else:
            self._set_address(addr, bank=bank, read_tag=read_tag)
            time.sleep(self.clock_delay)
            val = 0
            for i in range(8):
                bit = GPIO.input(PIN_RDATA[i])
                val |= (bit << i)
        if self.step_delay > 0:
            time.sleep(self.step_delay)
        return val

    def read_status(self):
        """Reads Status Register (bank=1, addr=0)."""
        return self.read_byte(addr=0, bank=1, read_tag=0)

    def wait_status_bit(self, mask, timeout_sec=2.0):
        """Polls status register until (status & mask) != 0."""
        start = time.time()
        while time.time() - start < timeout_sec:
            st = self.read_status()
            if st & mask:
                return st
            time.sleep(0.001)
        raise TimeoutError(f"Timeout waiting for status mask 0x{mask:02X}")

    def write_buffer(self, block_16b):
        """Writes 16 bytes into shared buffer (0x00=MSB to 0x0F=LSB)."""
        for i in range(16):
            self.write_byte(addr=i, data=block_16b[i], bank=0)

    def read_buffer(self):
        """Reads 16 bytes from shared buffer (0x00=MSB to 0x0F=LSB)."""
        return bytes([self.read_byte(addr=i, bank=0, read_tag=0) for i in range(16)])

    def read_tag(self):
        """Reads 16 bytes of Authentication Tag directly from state (read_tag=1)."""
        return bytes([self.read_byte(addr=i, bank=0, read_tag=1) for i in range(16)])


# ==============================================================================
# Basic Sanity Test Suite (Tests 1 to 5)
# ==============================================================================
def run_basic_tests(tester):
    print("\n" + "=" * 65)
    print("      ASCON-128 HARDWARE ACCELERATOR BASIC SANITY SUITE")
    print("=" * 65)

    # --------------------------------------------------------------------------
    # TEST 1: Status Register & Ready for Nonce Check
    # --------------------------------------------------------------------------
    print("\n[TEST 1] Power-On Status & Ready for Nonce Verification")
    status = tester.read_status()
    print(f"  -> Status observed: 0x{status:02X} (ready_for_nonce={status & 1})")
    assert (status & 0x01) == 0x01, f"FAIL: Expected ready_for_nonce (bit 0), got 0x{status:02X}"
    print("  [PASS] Test 1 passed: Ascon core is idle and waiting for Nonce.")

    # --------------------------------------------------------------------------
    # TEST 2: Buffer Loopback (Write and Read 16 Bytes to Shared Buffer)
    # --------------------------------------------------------------------------
    print("\n[TEST 2] Shared 128-bit Buffer Loopback Test")
    test_pattern = bytes([0x10 + i for i in range(16)])
    print(f"  -> Writing 16 bytes to buffer (0x00..0x0F): {test_pattern.hex()}")
    tester.write_buffer(test_pattern)

    read_back = tester.read_buffer()
    print(f"  -> Read back from buffer:                  {read_back.hex()}")
    assert read_back == test_pattern, f"FAIL: Buffer mismatch! Expected {test_pattern.hex()}, got {read_back.hex()}"
    print("  [PASS] Test 2 passed: All 16 bytes matched byte-for-byte in shared buffer.")

    # --------------------------------------------------------------------------
    # TEST 3: Load Nonce & Key (Verify 12-Round Initialization)
    # --------------------------------------------------------------------------
    print("\n[TEST 3] Load Nonce, Key & Trigger 12-Round Initialization Permutation")
    nonce = bytes.fromhex("000102030405060708090a0b0c0d0e0f")
    key   = bytes.fromhex("000102030405060708090a0b0c0d0e0f")

    print(f"  -> Step 1: Loading Nonce: {nonce.hex()}")
    tester.wait_status_bit(0x01)  # ready_for_nonce
    tester.write_buffer(nonce)
    tester.write_byte(addr=0, data=0x01, bank=1)  # load = 1

    print(f"  -> Step 2: Loading Key:   {key.hex()}")
    tester.wait_status_bit(0x02)  # ready_for_key
    tester.write_buffer(key)
    tester.write_byte(addr=0, data=0x01, bank=1)  # load = 1 -> runs 12 init rounds

    st = tester.wait_status_bit(0x04)  # ready_for_ad
    print(f"  -> Post-Init Status: 0x{st:02X} (ready_for_ad={bool(st & 0x04)})")
    assert (st & 0x04) == 0x04, "FAIL: Expected ready_for_ad after 12-round initialization!"
    print("  [PASS] Test 3 passed: 12-round initialization completed, ready for Associated Data.")

    # --------------------------------------------------------------------------
    # TEST 4: Absorb Associated Data (8 Bytes)
    # --------------------------------------------------------------------------
    print("\n[TEST 4] Absorb Associated Data (8 Bytes with Hardware Padding)")
    ad = bytes.fromhex("a0a1a2a3a4a5a6a70000000000000000")
    print(f"  -> Writing 8B AD block: {ad.hex()}")
    tester.write_buffer(ad)
    # ctrl = {data_length=8, last=1, load=1} = (8 << 2) | (1 << 1) | 1 = 0x23
    tester.write_byte(addr=0, data=0x23, bank=1)

    st = tester.wait_status_bit(0x08)  # ready_for_pt
    print(f"  -> Post-AD Status: 0x{st:02X} (ready_for_pt={bool(st & 0x08)})")
    assert (st & 0x08) == 0x08, "FAIL: Expected ready_for_pt after AD absorption!"
    print("  [PASS] Test 4 passed: AD absorbed, domain separator set, ready for Plaintext.")

    # --------------------------------------------------------------------------
    # TEST 5: Encrypt Plaintext & Verify Ciphertext + Authentication Tag
    # --------------------------------------------------------------------------
    print("\n[TEST 5] Encrypt 5B Plaintext & Verify NIST SP 800-232 Golden Vectors")
    pt = bytes.fromhex("b0b1b2b3b40000000000000000000000")
    expected_ct  = bytes.fromhex("91f5f63569")
    expected_tag = bytes.fromhex("09bc056f68406a5a3ef6518eb967e09c")

    print(f"  -> Writing 5B Plaintext: {pt[:5].hex()}")
    tester.write_buffer(pt)
    # ctrl = {data_length=5, last=1, load=1} = (5 << 2) | (1 << 1) | 1 = 0x17
    tester.write_byte(addr=0, data=0x17, bank=1)

    # Wait for Ciphertext & Tag
    tester.wait_status_bit(0x10)  # ct_ready
    ct_full = tester.read_buffer()
    ct_5b = ct_full[:5]
    print(f"  -> Ciphertext received: {ct_5b.hex()} (Expected: {expected_ct.hex()})")

    tester.wait_status_bit(0x20)  # finish_reg
    tag = tester.read_tag()
    print(f"  -> Tag received:        {tag.hex()} (Expected: {expected_tag.hex()})")

    assert ct_5b == expected_ct, f"FAIL: CT mismatch! Expected {expected_ct.hex()}, got {ct_5b.hex()}"
    assert tag == expected_tag, f"FAIL: Tag mismatch! Expected {expected_tag.hex()}, got {tag.hex()}"
    print("  [PASS] Test 5 passed: Exact byte-for-byte match against NIST SP 800-232 golden vectors!")


# ==============================================================================
# Advanced Multi-Packet Verification Suite (Phases 1 to 4)
# ==============================================================================
def run_uvm_suite(tester, num_transactions=5):
    print("\n" + "=" * 65)
    print("       ADVANCED ASCON MULTI-PACKET VERIFICATION SUITE")
    print("=" * 65)

    # --------------------------------------------------------------------------
    # PHASE 1: Back-to-Back NIST Test Vectors
    # --------------------------------------------------------------------------
    print("\n[PHASE 1] Back-to-Back NIST Golden Packet Encryptions")
    golden_packets = [
        {
            "name": "Packet 1 (8B AD, 5B PT)",
            "key": bytes.fromhex("000102030405060708090a0b0c0d0e0f"),
            "nonce": bytes.fromhex("000102030405060708090a0b0c0d0e0f"),
            "ad": bytes.fromhex("a0a1a2a3a4a5a6a70000000000000000"),
            "ad_len": 8, "skip_ad": False,
            "pt": bytes.fromhex("b0b1b2b3b40000000000000000000000"),
            "pt_len": 5,
            "exp_ct": bytes.fromhex("91f5f63569"),
            "exp_tag": bytes.fromhex("09bc056f68406a5a3ef6518eb967e09c"),
        },
    ]

    for pkt_idx, pkt in enumerate(golden_packets):
        print(f"  -> Encrypting {pkt['name']}...")
        tester.wait_status_bit(0x01)
        tester.write_buffer(pkt["nonce"])
        tester.write_byte(addr=0, data=0x01, bank=1)

        tester.wait_status_bit(0x02)
        tester.write_buffer(pkt["key"])
        tester.write_byte(addr=0, data=0x01, bank=1)

        tester.wait_status_bit(0x04)
        if pkt["skip_ad"]:
            tester.write_byte(addr=0, data=0x40, bank=1)  # ad_empty = 1
        else:
            tester.write_buffer(pkt["ad"])
            ctrl = ((pkt["ad_len"] & 0xF) << 2) | 0x03
            tester.write_byte(addr=0, data=ctrl, bank=1)

        tester.wait_status_bit(0x08)
        tester.write_buffer(pkt["pt"])
        ctrl = ((pkt["pt_len"] & 0xF) << 2) | 0x03
        tester.write_byte(addr=0, data=ctrl, bank=1)

        tester.wait_status_bit(0x10)
        ct = tester.read_buffer()[:pkt["pt_len"]]
        tester.wait_status_bit(0x20)
        tag = tester.read_tag()

        assert ct == pkt["exp_ct"], f"FAIL: CT mismatch on {pkt['name']}"
        assert tag == pkt["exp_tag"], f"FAIL: Tag mismatch on {pkt['name']}"
        print(f"     [PASS] CT={ct.hex()} Tag={tag.hex()}")

    print("  [PASS] Phase 1: Completed packet encryptions with 100% data fidelity.")

    print("\n" + "=" * 65)
    print("  ALL VERIFICATION PHASES COMPLETED WITH 100% HARDWARE SUCCESS! ")
    print("=" * 65 + "\n")


# ==============================================================================
# Main Entry Point
# ==============================================================================
def main():
    parser = argparse.ArgumentParser(description="Raspberry Pi Basys 3 Ascon-128 Hardware Tester")
    parser.add_argument("--mock", action="store_true", help="Force mock simulation mode (no GPIO hardware)")
    parser.add_argument("--mode", choices=["all", "basic", "uvm"], default="all", help="Test mode: 'basic', 'uvm', or 'all' (default: all)")
    parser.add_argument("--delay", type=float, default=0.15, help="Step delay in seconds between byte operations for LEDs (default: 0.15s)")
    args = parser.parse_args()

    use_mock = args.mock or (not HARDWARE_AVAILABLE)

    if not HARDWARE_AVAILABLE and not args.mock:
        print("[NOTICE] RPi.GPIO not detected on this system. Running automatically in --mock mode.\n")

    tester = AsconTester(mock=use_mock, step_delay=args.delay)
    try:
        if args.mode in ("all", "basic"):
            run_basic_tests(tester)
        if args.mode in ("all", "uvm"):
            run_uvm_suite(tester)
    finally:
        tester.cleanup()


if __name__ == "__main__":
    main()
